MKEadmin/Waterpomp/code_computer/Prullebakken_org.png

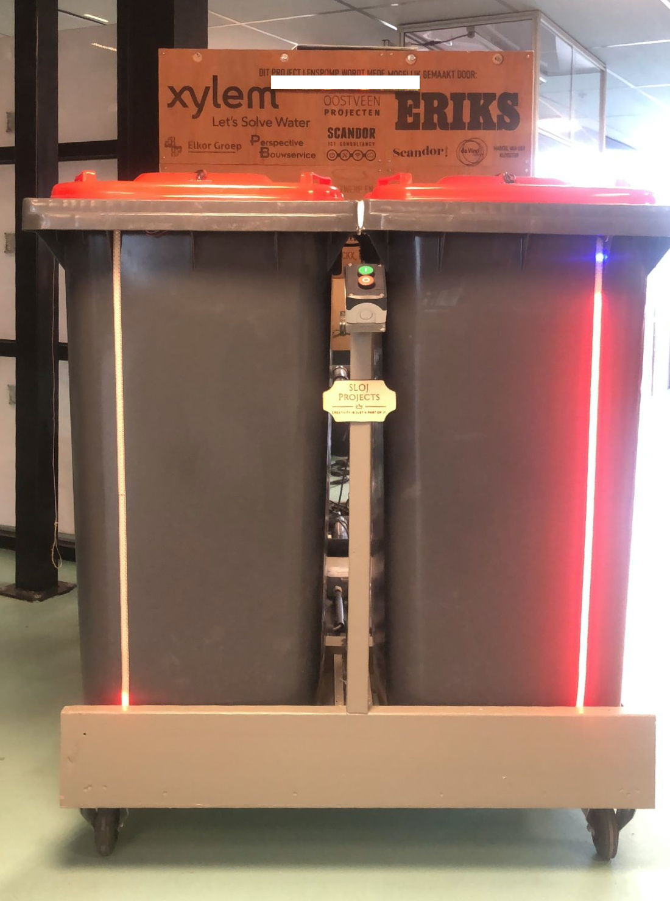
code_computer/Prullebakken_org.png
