MKEadmin/Waterpomp/Documentatie/SLOJ - Motoren en prullebakken/SLOJZERO_Test_1.pdf

# SLOJ PROJECTS

### TESTDOCUMENT I: FUNCTIONALITEIT EN BASIS TESTEN

SLOJ ZERO TEST OPSTELLING

### Getest door: Gecontroleerd door: Test datum: Test formulier nummer:

SLOJ PROJECTS | TESTDOCUMENT I
Schouten, Luijckx, Oostveen en de Jong | Functionaliteit en basis (15 punten)

### Fysieke test

Alleen uit te voeren als tanks gevuld zijn met water en systeem geopend is.

Test punt | Beschrijving | Ja | Nee
1.1 | Pompen lekken geen in de gehele installatie. ✓ Kleppen dienen handmatig open gezet te worden

Opmerkingen

Test punt | Beschrijving | Ja | Nee
1.2 | Installatie niet in bedrijf, projecteert een druk van 0 bar op de displays

Opmerkingen

Schouten, Luijckx, Oostveen en de Jong | Functionaliteit en basis (15 punten)

### Elektrotechnische test:

Systeem aangesloten op drie-fase net 400VAC 50Hz

Test punt | Beschrijving | Ja | Nee
2.1 | ‘Spanning in bedrijf’ lamp 10H1 brandt continu zonder flikkeringen. Automaat 10F1 ingeschakeld en hoofdschakelaar 10S1

Opmerkingen

Test punt | Beschrijving | Ja | Nee
2.2 | Beide pompen tegelijk inschakelen op vol vermogen zonder dat: ✓ Automaat 10F1 afschakelt ✓ MCB 40Q1 / 40Q2 afschakelen ✓ Buitenstaande automaten afschakelen

Opmerkingen

Test punt | Beschrijving | Ja | Nee | Waardes
2.3 | Inkomende spanning 400V. Gemeten op 10S1 Tussen L1-L2, L1-L3, L2-L3, L1-N, L2-N, L3-N | | | L1-L2: L1-L3: L2-L3: L1-N: L2-N: L3-N

Opmerkingen

Test punt | Beschrijving | Ja | Nee
2.4 | PLC reageert op alle inputs (check op display)

Opmerkingen

Schouten, Luijckx, Oostveen en de Jong | Functionaliteit en basis (15 punten)

### Meet- en regel test:

Test punt | Beschrijving | Ja | Nee
3.1 | Pomp 1 inschakelen: ✓ Handmatige functie activeren (20S3) ✓ Schakel kleppen om op de schakelkast. Neem waar dat de flow omdraait. (

Opmerkingen

Test punt | Beschrijving | Ja | Nee
3.2 | Pomp 2 inschakelen volgens ‘Remote Control’: ✓ Schakelkast in handmatige functie zetten (20S3) ✓ Op Remote Control 2 keer de aan functie (24S1) opvragen met een tussenpauze van 1 seconde. ✓ Schakel de kleppen door de aan functie drie seconde in gedrukt te houden

Opmerkingen

Test punt | Beschrijving | Ja | Nee
3.3 | Druk loopt bij vol vermogen (pomp 1 en 2 actief) niet hoger op dan 8,1BAR
3.4 Druk loop bij half vermogen (pomp 1 of 2) | niet hoger op dan 6,1 BAR
3.5 | Druk loopt bij half vermogen (pomp 1 of 2) niet bij de niet-draaiende pomp hoger op dan 1,5 BAR
| Opmerkingen

Schouten, Luijckx, Oostveen en de Jong | Functionaliteit en basis (15 punten)

### Functie testen:

Test punt | Beschrijving | Ja | Nee
4.1 | Functie automatisch programma: Voorwaarden: ✓ Tank 1 is gevuld . ✓ Tank 2 is volledig leeg (Vlotter LAAG geeft een laag signaal af). Functie test: ✓ Bij inschakelen slaan beide pompen aan . ✓ Bij ‘Vlotter MIDDEN’ slaat er één pomp af. ✓ Blij ‘Vlotter HOOG’ slaan alle pompen af.

Opmerkingen

Test punt | Beschrijving | Ja | Nee
4.2 | Functie demo programma: Voorwaarden: ✓ Automatisch programma is ingeschakeld Functie test: ✓ Druk de uitknop (20S2/ 24S2) 10 seconden in ✓ Tank 2 wordt gevuld tot Vlotter HOOG ✓ Omkeer schakeling schakelt kleppen om ✓ Tank 1 wordt gevuld totdat Vlotter LAAG in Tank 2 laag is

Opmerkingen

Schouten, Luijckx, Oostveen en de Jong | Functionaliteit en basis (15 punten)
Test punt | Beschrijving | Ja | Nee
4.3 | Functie: Remote control I Voorwaarden: ✓ Handmatig programma geactiveerd Functie test: ✓ Druk de aan knop (24S1) eenmaal in. Pomp 1 gaat nu aan ✓ Druk de aan knop (24S1) nogmaals in. Pomp 2 gaat nu aan en pomp 1 valt af ✓ Druk de aan knop (24S1) nogmaals in. Beide pompen draaien nu

Opmerkingen

Test punt | Beschrijving | Ja | Nee
4.4 | Functie: Remote control II Voorwaarden: ✓ Handmatig programma geactiveerd ✓ Pompen draaien niet Functie test: ✓ Druk de aan knop (24S1) in voor drie seconden, neem waar dat de kleppen omschakelen ✓ Druk de aan knop (24S1) eenmaal in zodat pomp 1 gaat draaien ✓ Druk de aan knop (24S1) in voor drie seconde, neem waar dat de kleppen nogmaals omschakelen

Opmerkingen

Schouten, Luijckx, Oostveen en de Jong | Functionaliteit en basis (15 punten)

### Tijden controle:

Test punt | Beschrijving | Ja | Nee | Waardes
5.1 | Pomp 1 doet er maximaal xxx aantal seconden over om tank 1 over te pompen naar tank 2. | | | Tijd in seconden:
Test punt | Beschrijving | Ja | Nee | Waardes
5.2 | Pomp 1+2 doen er maximaal xxx aantal seconden over om tank 1 over te pompen naar tank 2. | | | Tijd in seconden:
