MKEadmin/Waterpomp/Documentatie/SLOJ - Motoren en prullebakken/DV_SLS005 SMARTLENS POMP revE AS BUILT.pdf

3011TT

## Leerpark

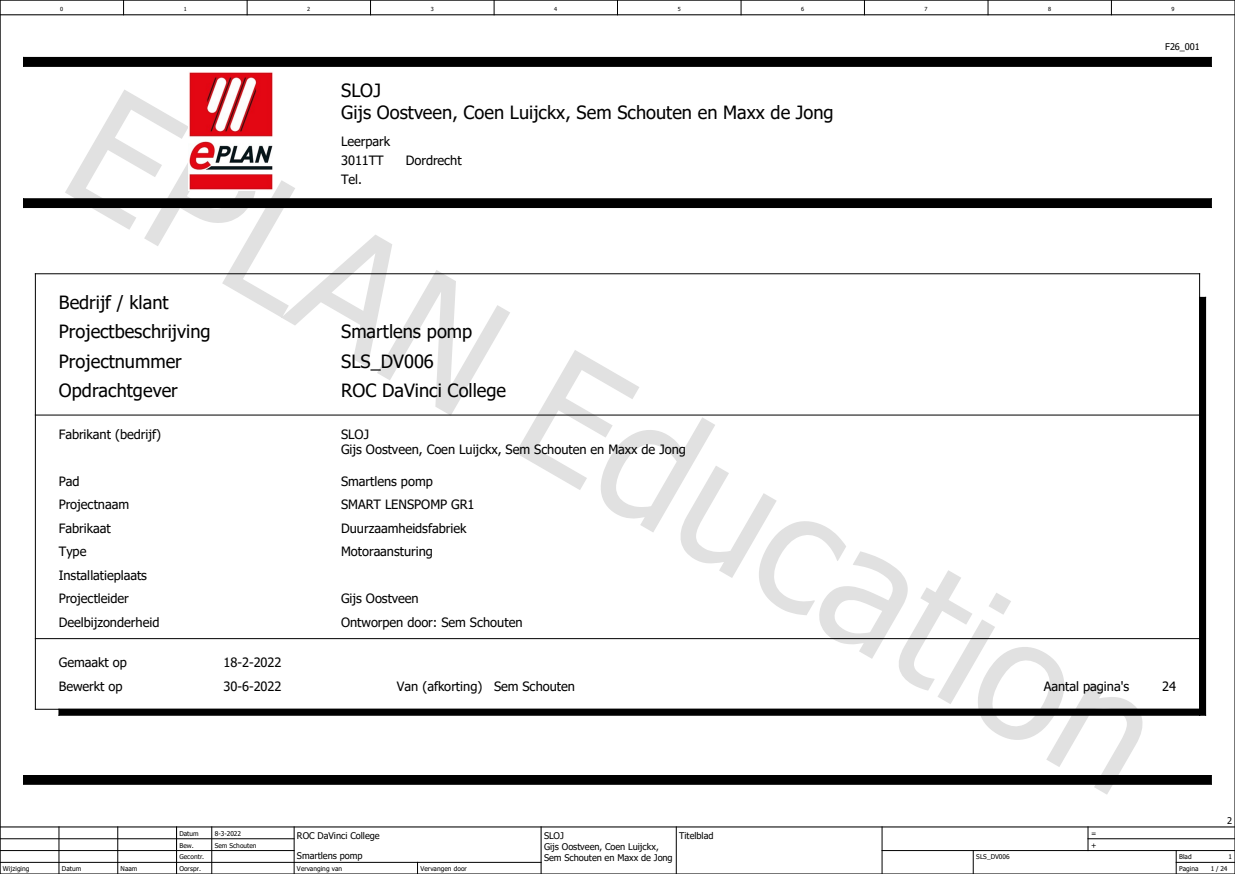
[picture p2: page 1]
Projectbeschrijving; Smartlens pomp; Aantal pagina's; Opdrachtgever; Bewerkt op; Gemaakt op; Duurzaamheidsfabriek; Projectnummer; Fabrikaat; Sem Schouten; Deelbijzonderheid; Pad; Motoraansturing; Fabrikant (bedrijf); Projectnaam; SMART LENSPOMP GR1; Projectleider; Tel.; Type; Bedrijf / klant; Installatieplaats; Van (afkorting); Dordrecht

SLOJ
Gijs Oostveen, Coen Luijckx, Sem Schouten en Maxx de Jong

SLS_DV006
ROC DaVinci College

Gijs Oostveen
Ontworpen door: Sem Schouten

8-3-2022 | ROC DaVinci College Smartlens pomp | SLOJ Gijs Oostveen, Coen Luijckx, Sem Schouten en Maxx de Jong | Titelblad | =

Bew. | Sem Schouten | | | | +
Gecontr. | | | | | SLS_DV006 | 1 Blad

Wijziging | Datum | Naam | Oorspr. | | Vervanging van | Vervangen door | | | | Pagina 1 / 24

# Inhoudsopgave

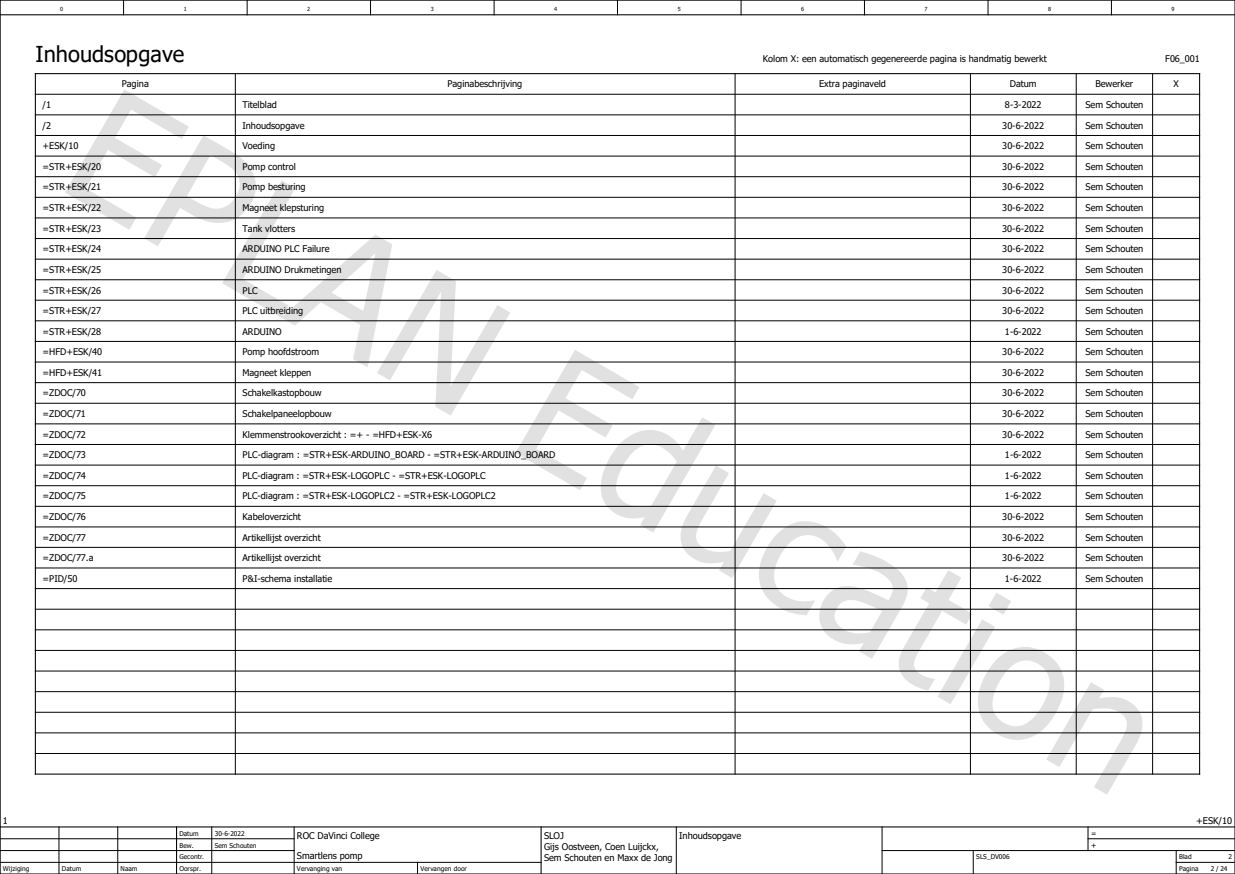
[picture p3: page 2]
Inhoudsopgave; +ESK/10; SLOJ; Sem Schouten en Maxx de Jong

Kolom X: een automatisch gegenereerde pagina is handmatig bewerkt

Pagina | Paginabeschrijving | Extra paginaveld | Datum | Bewerker | X

/1 | | | 8-3-2022 | Sem Schouten Titelblad
/2 | | | 30-6-2022 | Sem Schouten Inhoudsopgave
+ESK/10 | | | 30-6-2022 | Sem Schouten Voeding
=STR+ESK/20 | | | 30-6-2022 | Sem Schouten Pomp control
=STR+ESK/21 | | | 30-6-2022 | Sem Schouten Pomp besturing
=STR+ESK/22 | | | 30-6-2022 | Sem Schouten Magneet klepsturing
=STR+ESK/23 | | | 30-6-2022 | Sem Schouten Tank vlotters
=STR+ESK/24 | | | 30-6-2022 | Sem Schouten ARDUINO PLC Failure
=STR+ESK/25 | | | 30-6-2022 | Sem Schouten ARDUINO Drukmetingen
=STR+ESK/26 | | | 30-6-2022 | Sem Schouten PLC
=STR+ESK/27 | | | 30-6-2022 | Sem Schouten PLC uitbreiding
=STR+ESK/28 | | | 1-6-2022 | Sem Schouten ARDUINO
=HFD+ESK/40 | | | 30-6-2022 | Sem Schouten Pomp hoofdstroom
=HFD+ESK/41 | | | 30-6-2022 | Sem Schouten Magneet kleppen
=ZDOC/70 | | | 30-6-2022 | Sem Schouten Schakelkastopbouw
=ZDOC/71 | | | 30-6-2022 | Sem Schouten Schakelpaneelopbouw
=ZDOC/72 | | | 30-6-2022 | Sem Schouten Klemmenstrookoverzicht : =+ - =HFD+ESK-X6
=ZDOC/73 | | | 1-6-2022 | Sem Schouten PLC-diagram : =STR+ESK-ARDUINO_BOARD - =STR+ESK-ARDUINO_BOARD
=ZDOC/74 | | | 1-6-2022 | Sem Schouten PLC-diagram : =STR+ESK-LOGOPLC - =STR+ESK-LOGOPLC
=ZDOC/75 | | | 1-6-2022 | Sem Schouten PLC-diagram : =STR+ESK-LOGOPLC2 - =STR+ESK-LOGOPLC2
=ZDOC/76 | | | 30-6-2022 | Sem Schouten Kabeloverzicht
=ZDOC/77 | | | 30-6-2022 | Sem Schouten Artikellijst overzicht
=ZDOC/77.a | | | 30-6-2022 | Sem Schouten Artikellijst overzicht
=PID/50 | | | 1-6-2022 | Sem Schouten P&I-schema installatie

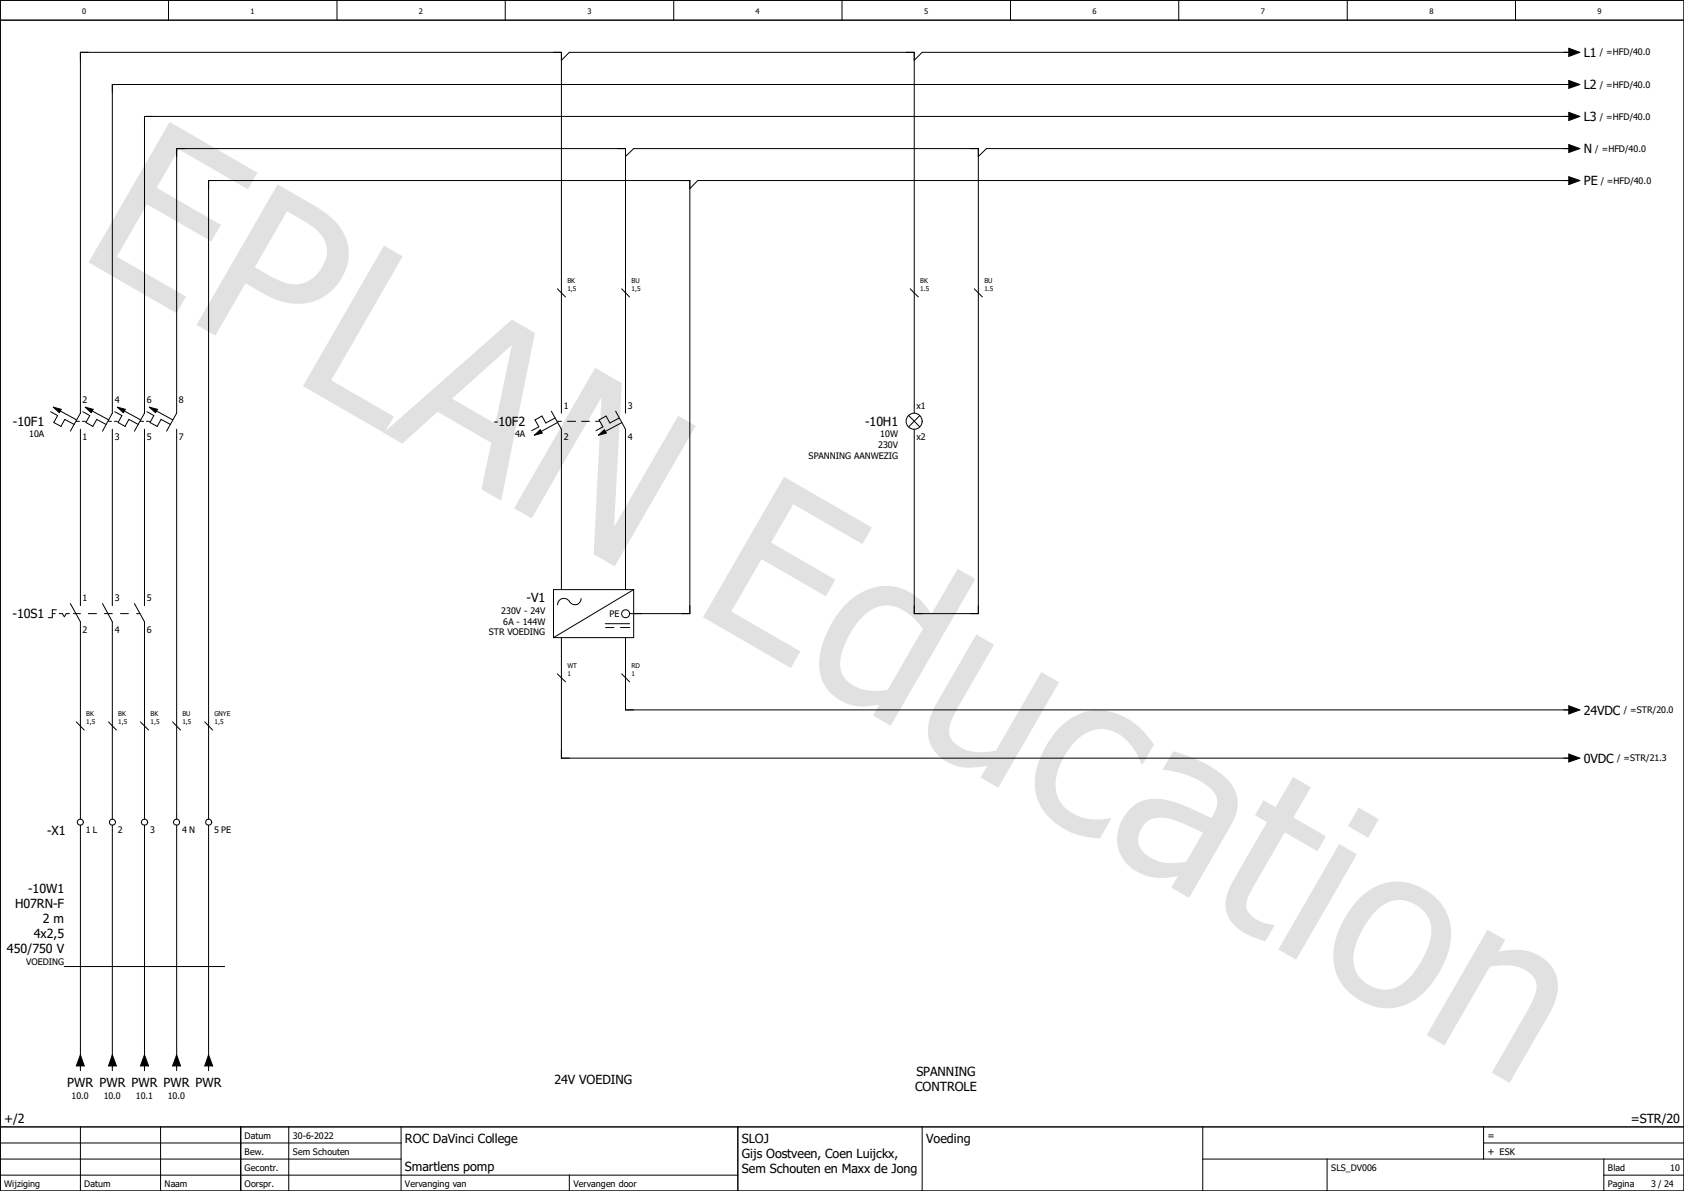
[picture p4: page 3]
ESK; Voeding; =STR/20; Sem Schouten en Maxx de Jong; SPANNING CONTROLE 24V VOEDING; -V1 230V - 24V 6A - 144W STR VOEDING; VOEDING; GNYE; -10H1 10W 230V SPANNING AANWEZIG; N / =HFD/40.0; PE / =HFD/40.0; 24VDC / =STR/20.0; L2 / =HFD/40.0; L3 / =HFD/40.0; PWR 10.0; PWR 10.1; PWR; 0VDC / =STR/21.3; L1 / =HFD/40.0

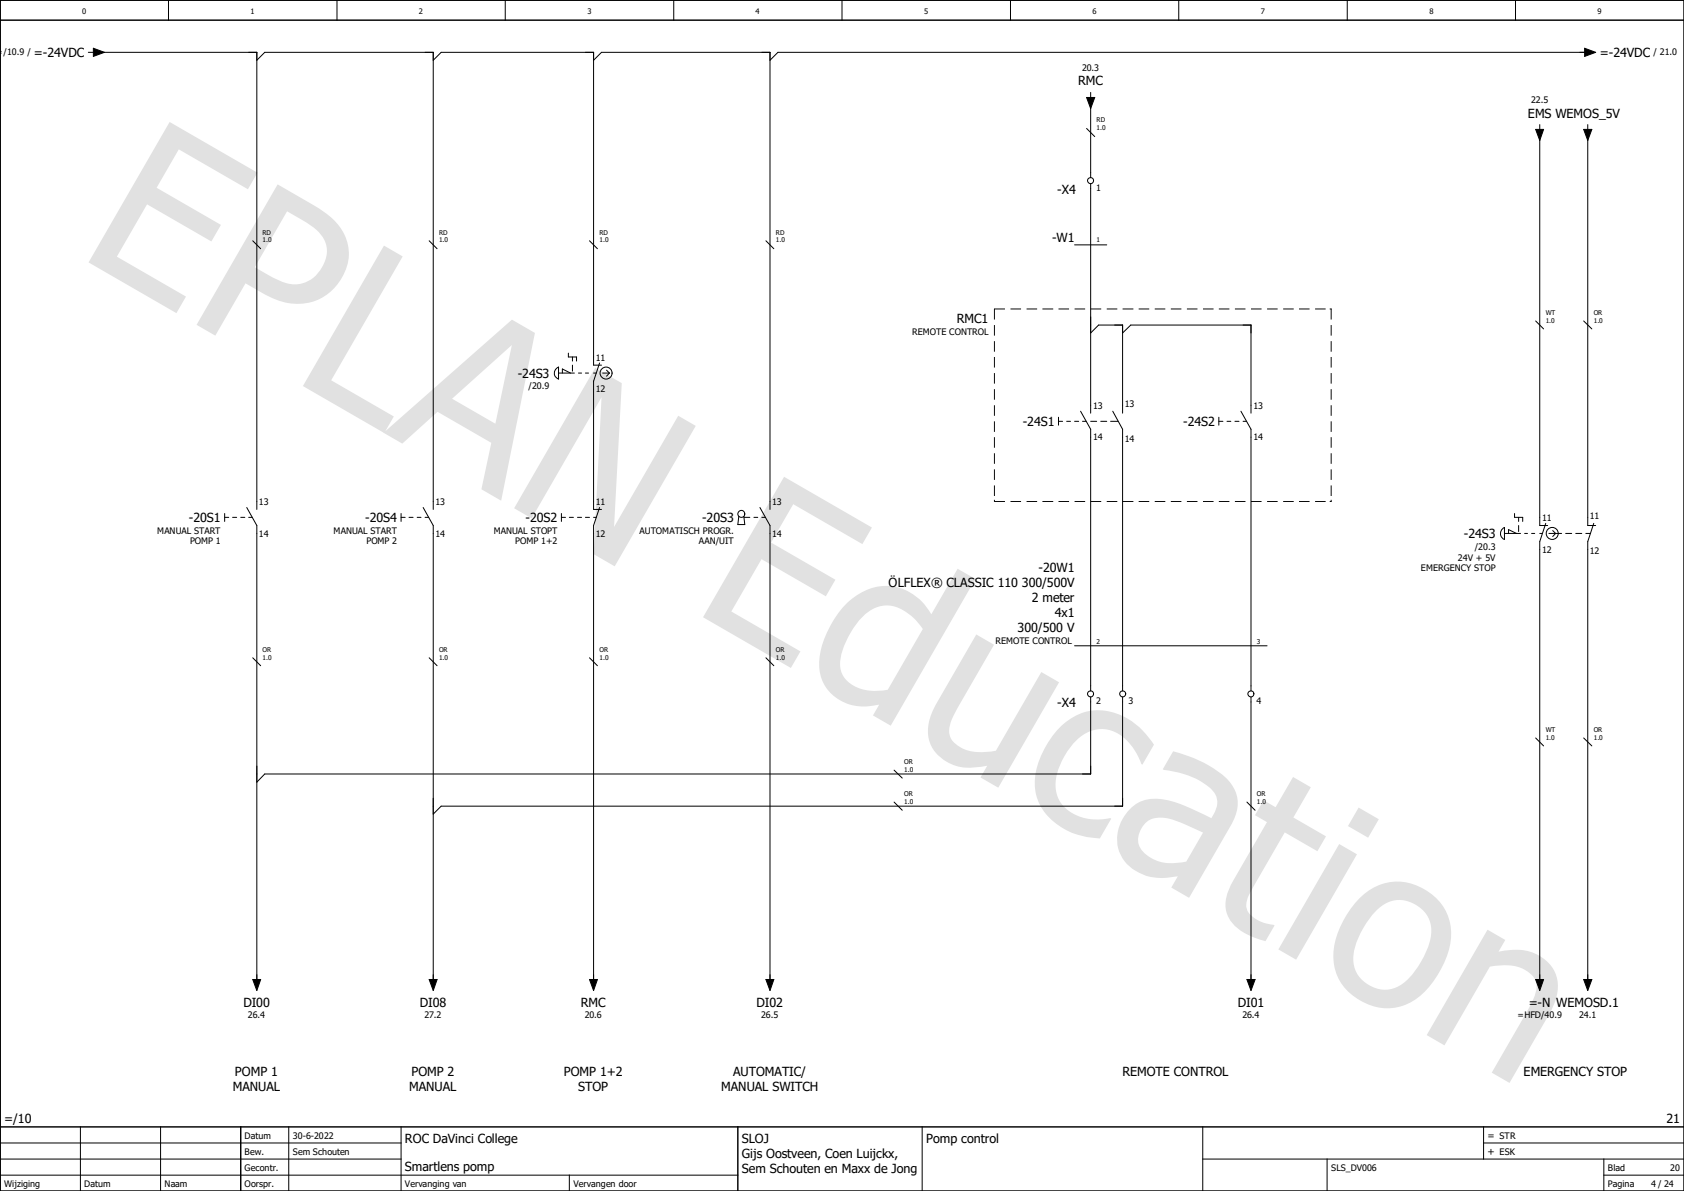
[picture p5: page 4]
STR; Pomp control; Sem Schouten en Maxx de Jong; POMP 1; REMOTE CONTROL; MANUAL; POMP 2 MANUAL; AUTOMATIC/ MANUAL SWITCH; POMP 1+2 STOP; EMERGENCY STOP; -20S1 MANUAL START POMP 1; -20S2 MANUAL STOPT POMP 1+2; -20S3 AUTOMATISCH PROGR. AAN/UIT; RMC1 REMOTE CONTROL; 2 meter; ÖLFLEX® CLASSIC 110 300/500V; -24S3 /20.3 24V + 5V EMERGENCY STOP; -20S4 MANUAL START POMP 2; =/10.9 / =-24VDC; =-24VDC / 21.0; WEMOS_5V; WEMOSD.1 24.1; =-N =HFD/40.9; EMS; RMC; RMC 20.6

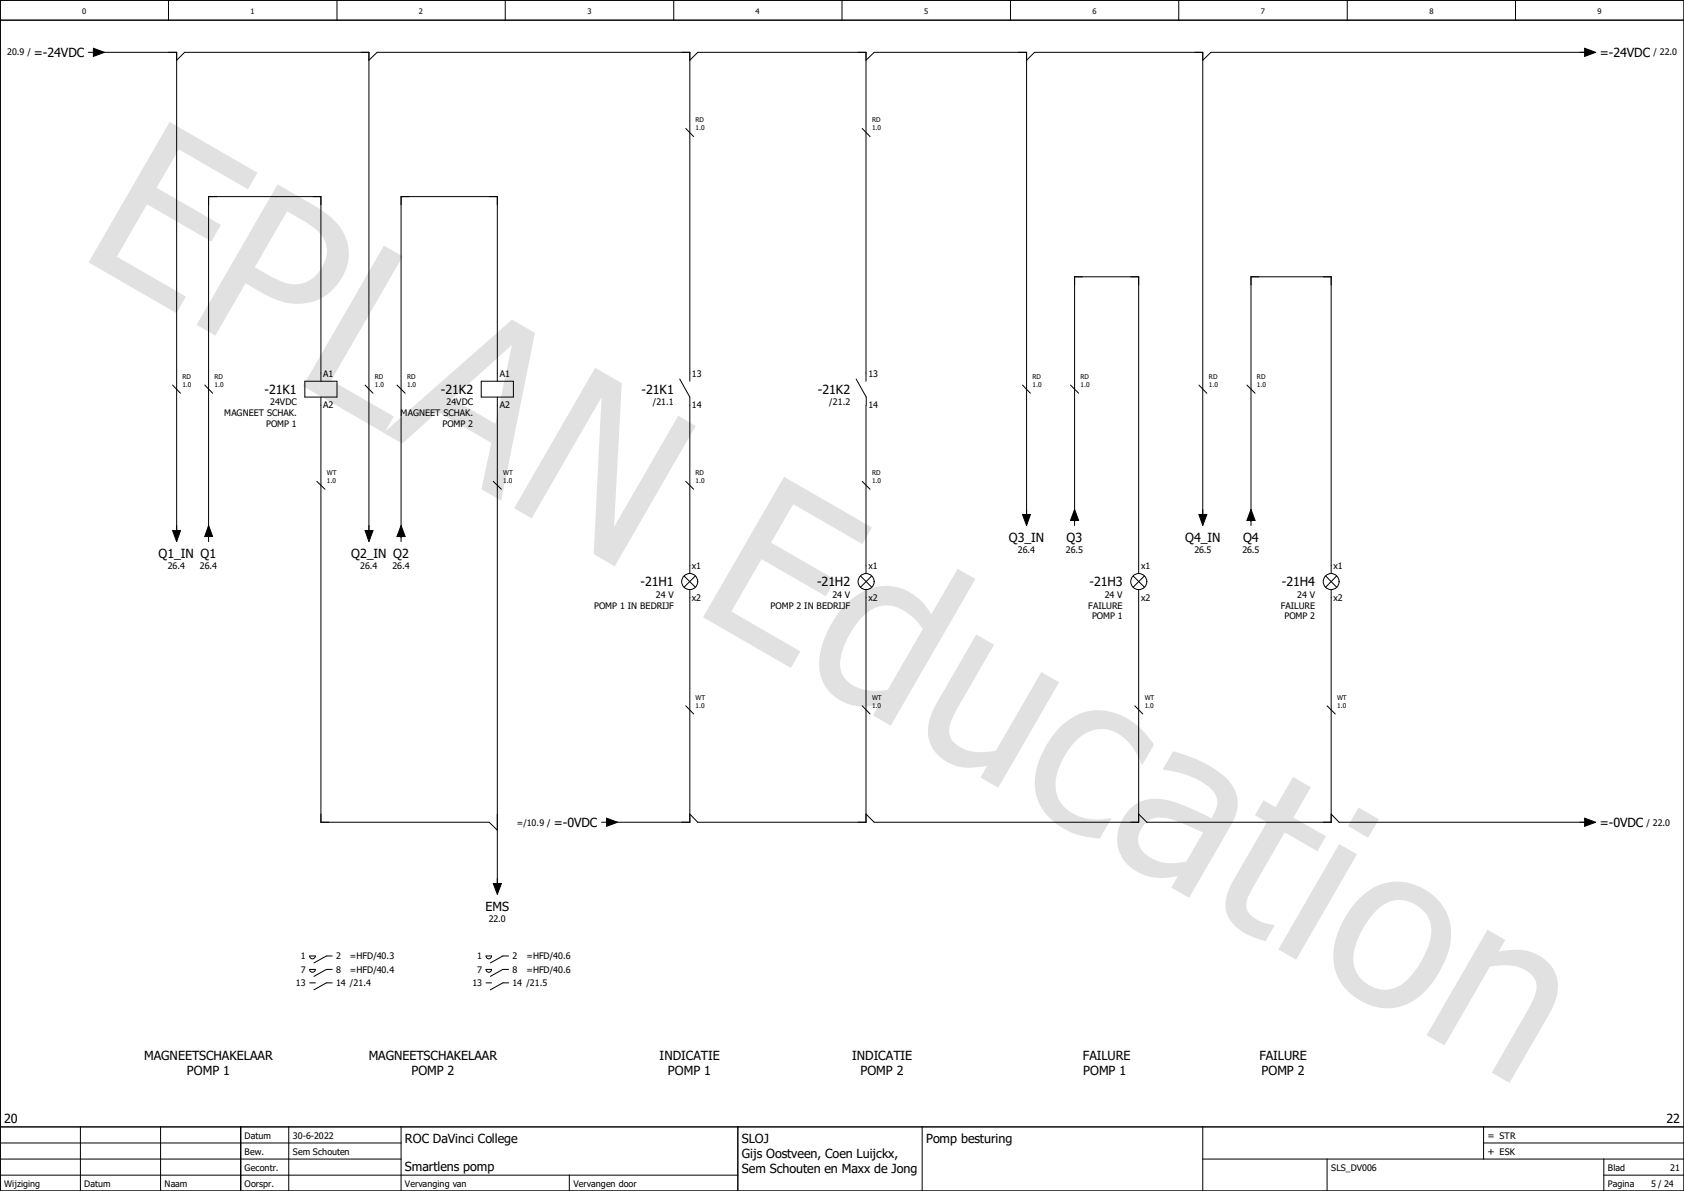
[picture p6: page 5]
STR; Pomp besturing; Sem Schouten en Maxx de Jong; MAGNEETSCHAKELAAR POMP 1; MAGNEETSCHAKELAAR POMP 2; INDICATIE POMP 1; INDICATIE POMP 2; FAILURE POMP 1; FAILURE POMP 2; -21K1 24VDC MAGNEET SCHAK. POMP 1; 1 2 =HFD/40.3 7 8 =HFD/40.4 13 14 /21.4; -21K2 24VDC MAGNEET SCHAK. POMP 2; 1 2 =HFD/40.6 7 8 =HFD/40.6 13 14 /21.5; -21H3 24 V FAILURE POMP 1; -21H4 24 V FAILURE POMP 2; 20.9 / =-24VDC; =-24VDC / 22.0; =/10.9 / =-0VDC; EMS 22.0; =-0VDC / 22.0

POMP 1 IN BEDRIJF

POMP 2 IN BEDRIJF

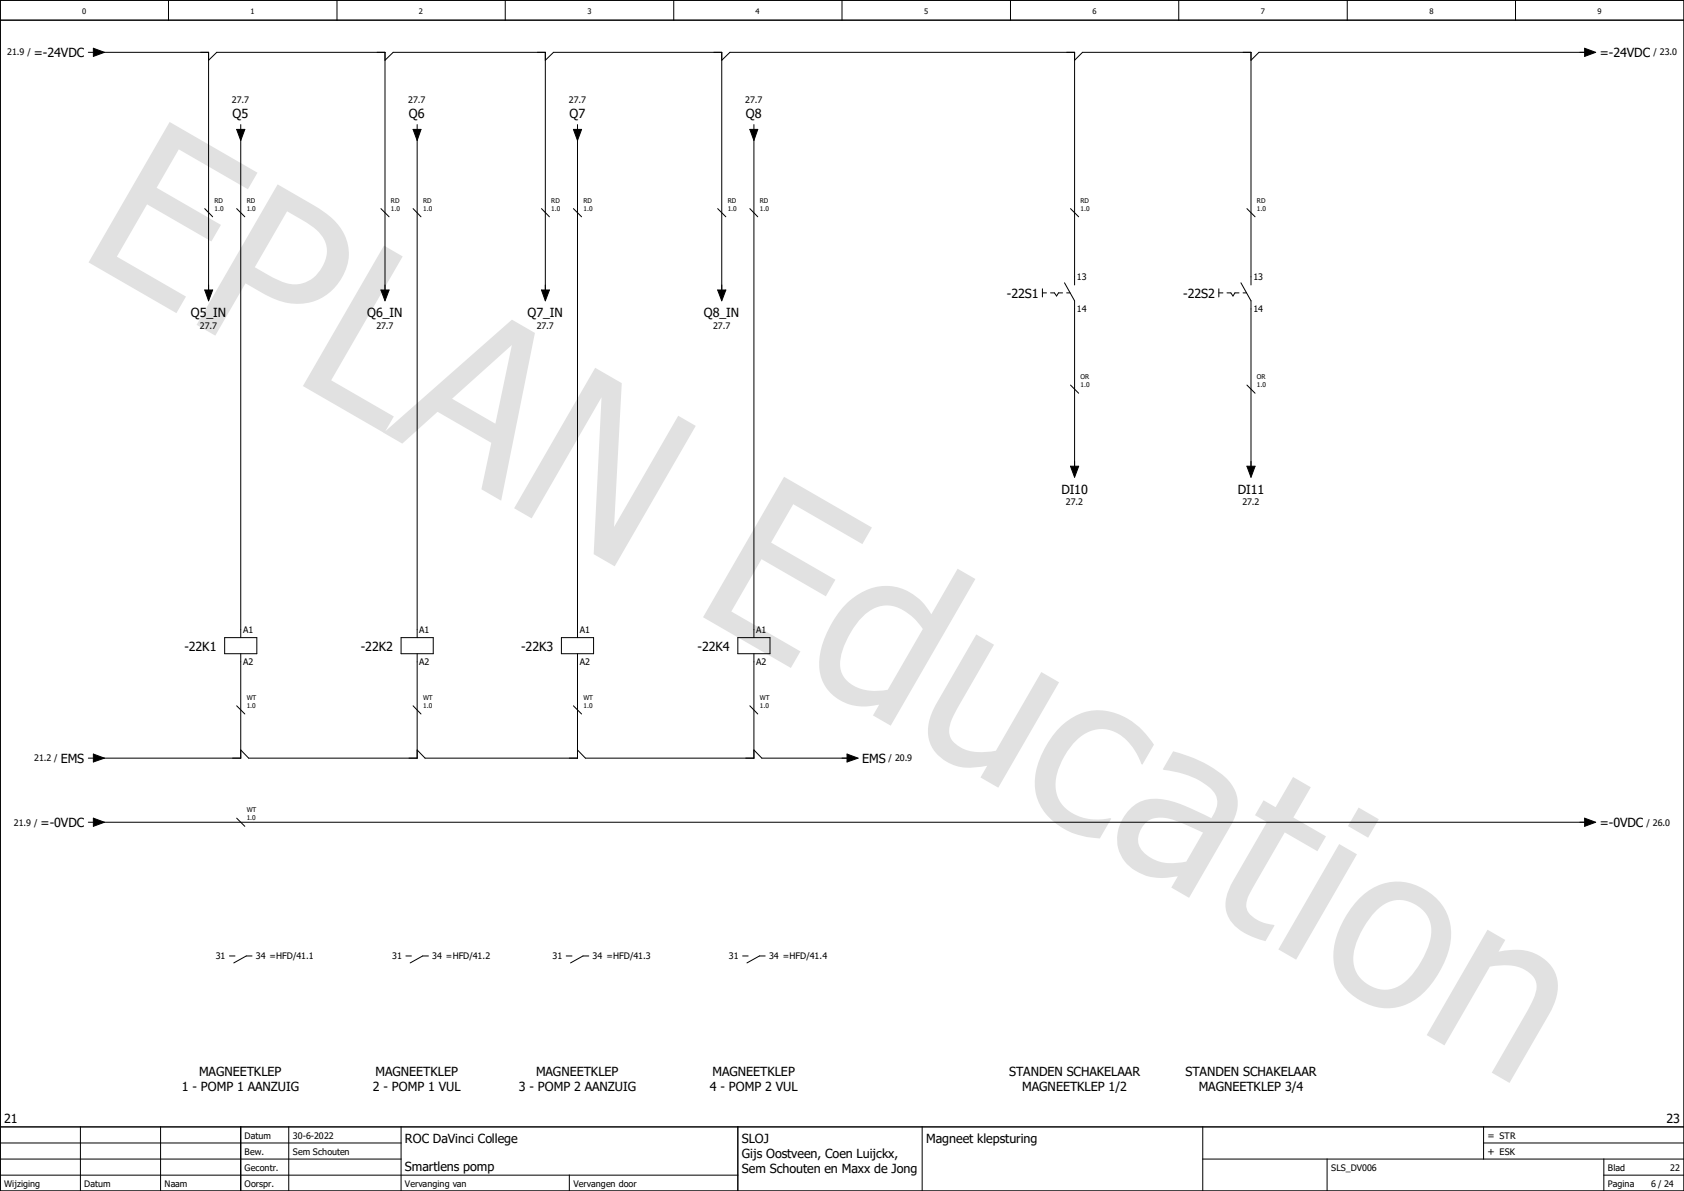
[picture p7: page 6]
STR; Magneet klepsturing; Sem Schouten en Maxx de Jong; MAGNEETKLEP 1 - POMP 1 AANZUIG; MAGNEETKLEP 2 - POMP 1 VUL; MAGNEETKLEP 3 - POMP 2 AANZUIG; MAGNEETKLEP 4 - POMP 2 VUL; STANDEN SCHAKELAAR MAGNEETKLEP 1/2; STANDEN SCHAKELAAR MAGNEETKLEP 3/4; 31 34 =HFD/41.1; 31 34 =HFD/41.2; 31 34 =HFD/41.3; 31 34 =HFD/41.4; 21.9 / =-24VDC; =-24VDC / 23.0; 21.2 / EMS; EMS / 20.9; 21.9 / =-0VDC; =-0VDC / 26.0

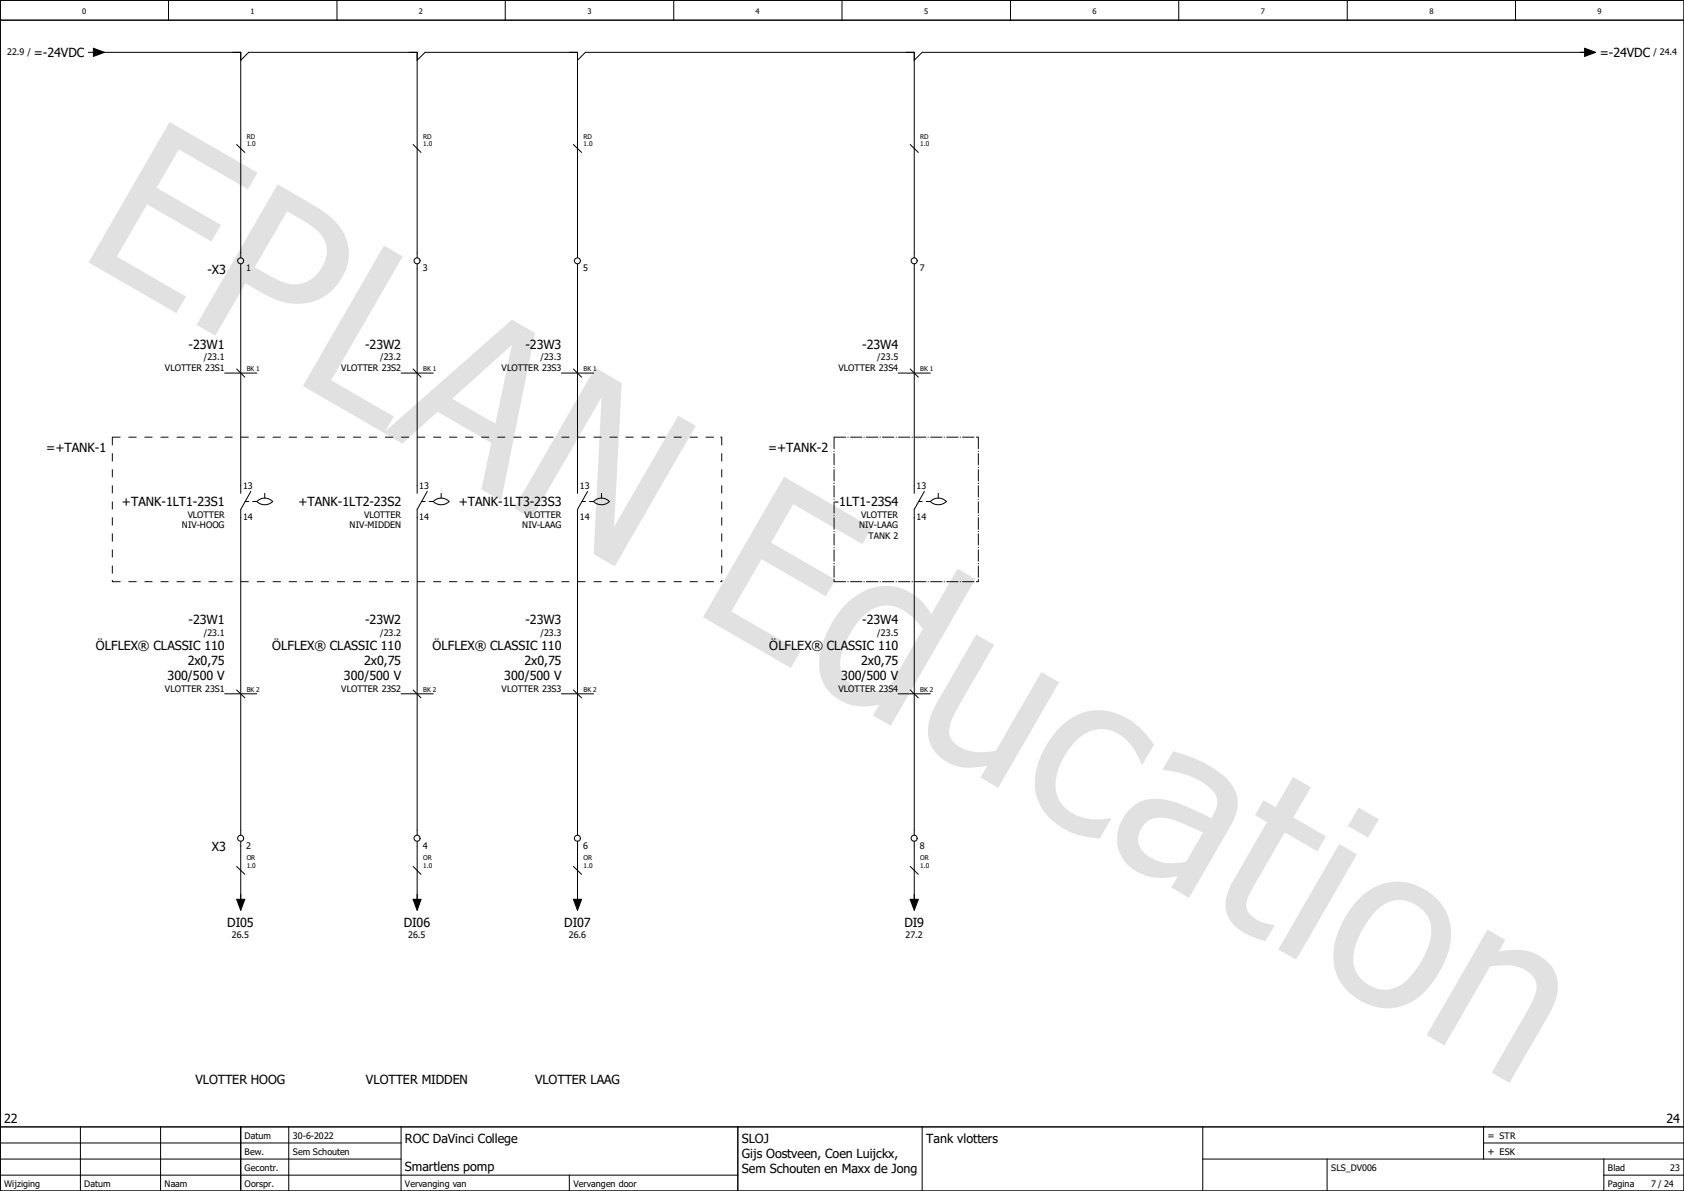
[picture p8: page 7]
STR; Tank vlotters; Sem Schouten en Maxx de Jong; VLOTTER HOOG; VLOTTER MIDDEN; VLOTTER LAAG; =+TANK-1; VLOTTER 23S1; ÖLFLEX® CLASSIC 110; VLOTTER 23S2; VLOTTER 23S3; +TANK-1LT1-23S1 VLOTTER NIV-HOOG; +TANK-1LT2-23S2 VLOTTER NIV-MIDDEN; +TANK-1LT3-23S3 VLOTTER NIV-LAAG; VLOTTER 23S4; -1LT1-23S4 VLOTTER NIV-LAAG TANK 2; =+TANK-2; 22.9 / =-24VDC; =-24VDC / 24.4

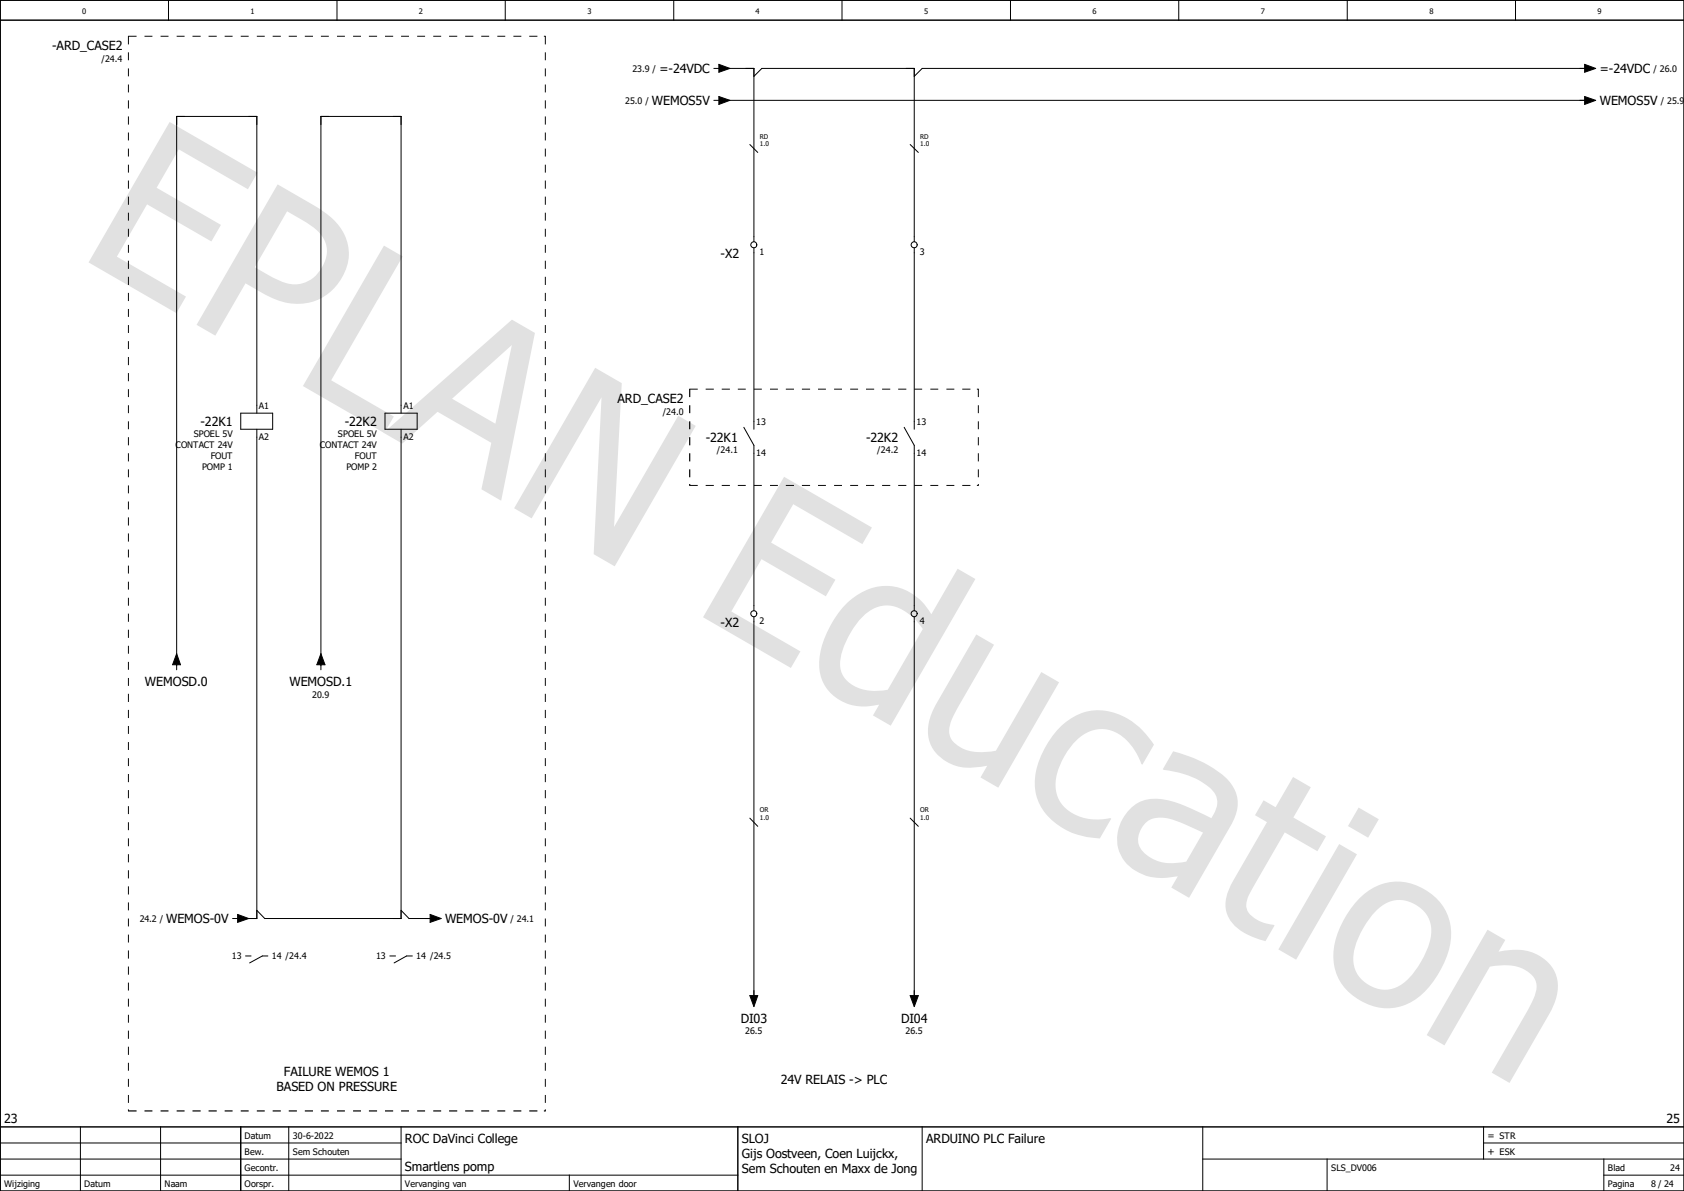
[picture p9: page 8]
STR; Sem Schouten en Maxx de Jong; FAILURE WEMOS 1; BASED ON PRESSURE; 24V RELAIS -> PLC; -22K1 SPOEL 5V CONTACT 24V FOUT POMP 1; -22K2 SPOEL 5V CONTACT 24V FOUT POMP 2; ARD_CASE2 /24.0; -ARD_CASE2 /24.4; 24.2 / WEMOS-0V; WEMOS-0V / 24.1; 23.9 / =-24VDC; =-24VDC / 26.0; WEMOSD.0; WEMOSD.1; 25.0 / WEMOS5V; WEMOS5V / 25.9

ARDUINO PLC Failure

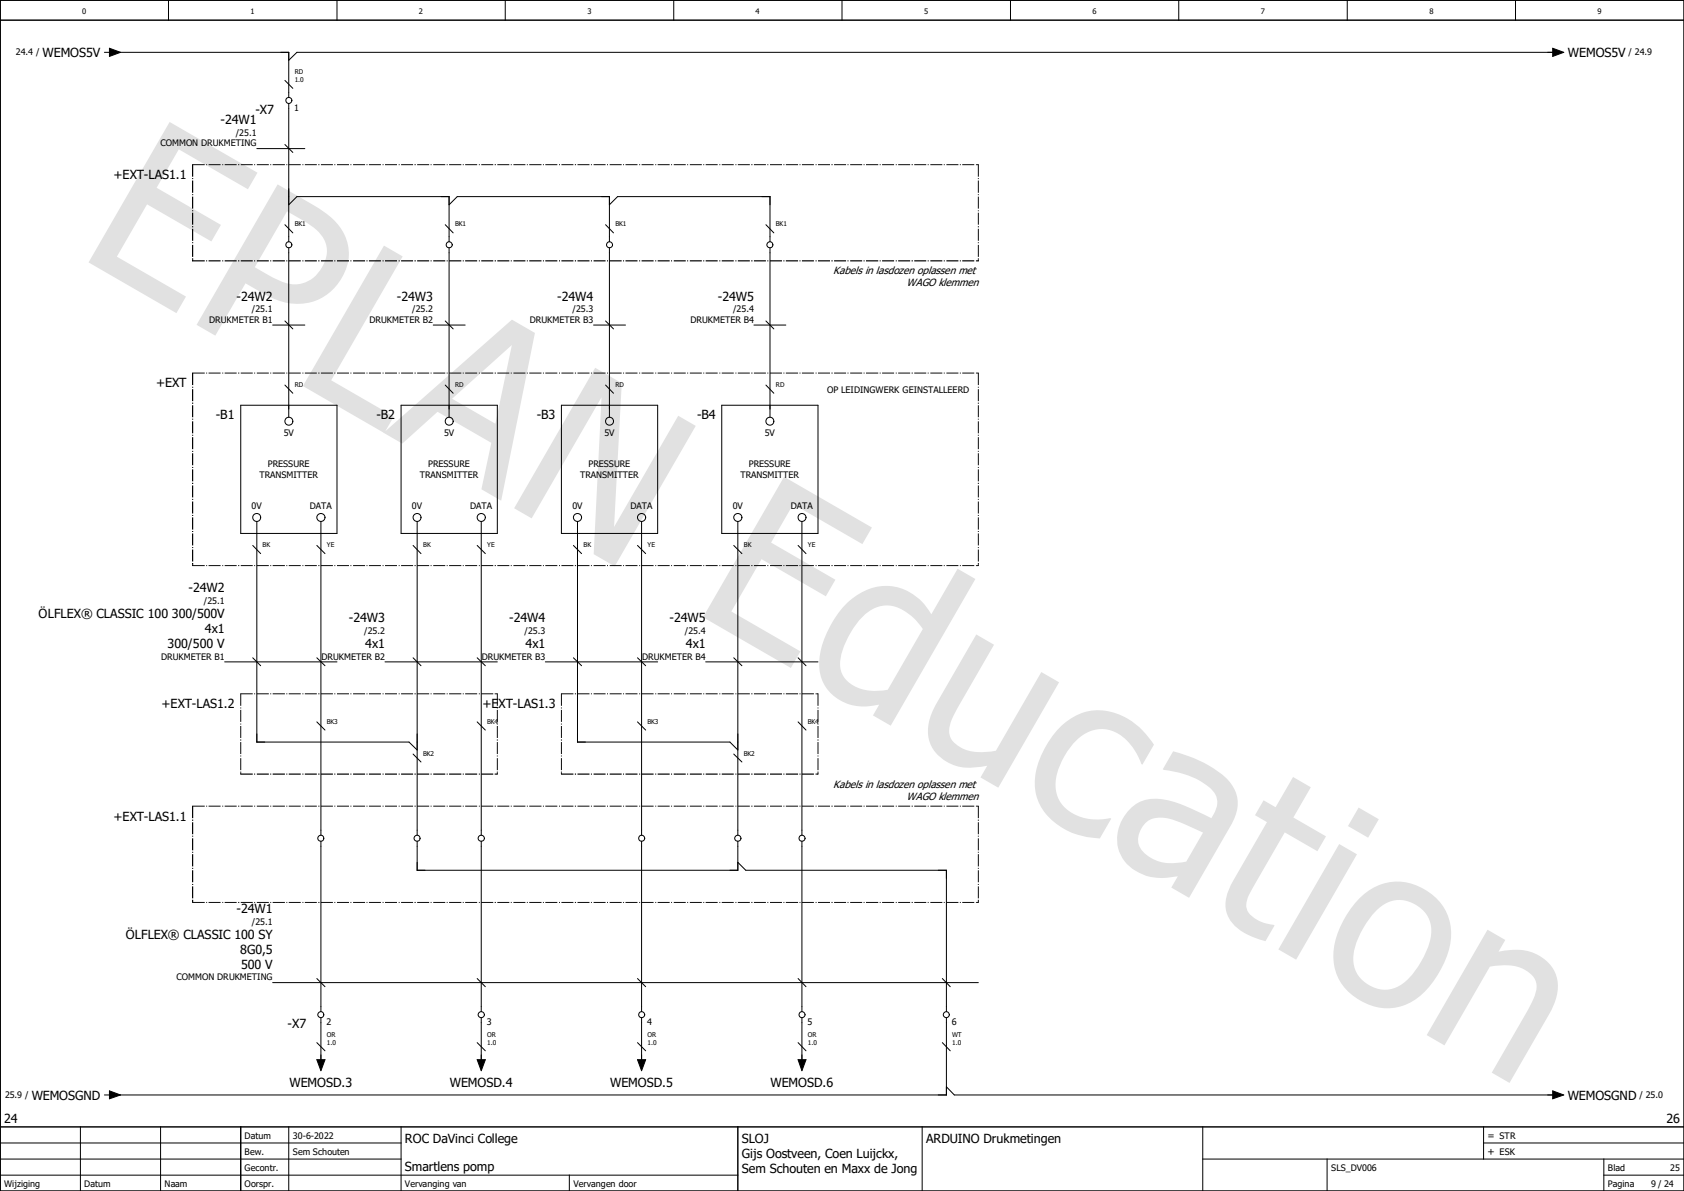
[picture p10: page 9]
STR; ARDUINO Drukmetingen; Sem Schouten en Maxx de Jong; PRESSURE TRANSMITTER; WAGO klemmen; +EXT-LAS1.1; DATA; COMMON DRUKMETING; DRUKMETER B1; ÖLFLEX® CLASSIC 100 300/500V; DRUKMETER B2; DRUKMETER B3; DRUKMETER B4; +EXT; +EXT-LAS1.2; +EXT-LAS1.3; 24.4 / WEMOS5V; WEMOS5V / 24.9; WEMOSD.3; WEMOSD.4; WEMOSD.5; WEMOSD.6; 25.9 / WEMOSGND; WEMOSGND / 25.0

Kabels in lasdozen oplassen met

OP LEIDINGWERK GEINSTALLEERD

ÖLFLEX® CLASSIC 100 SY

## I1 I0.0 MANUAL START

## I2 I0.1 MANUAL STOP

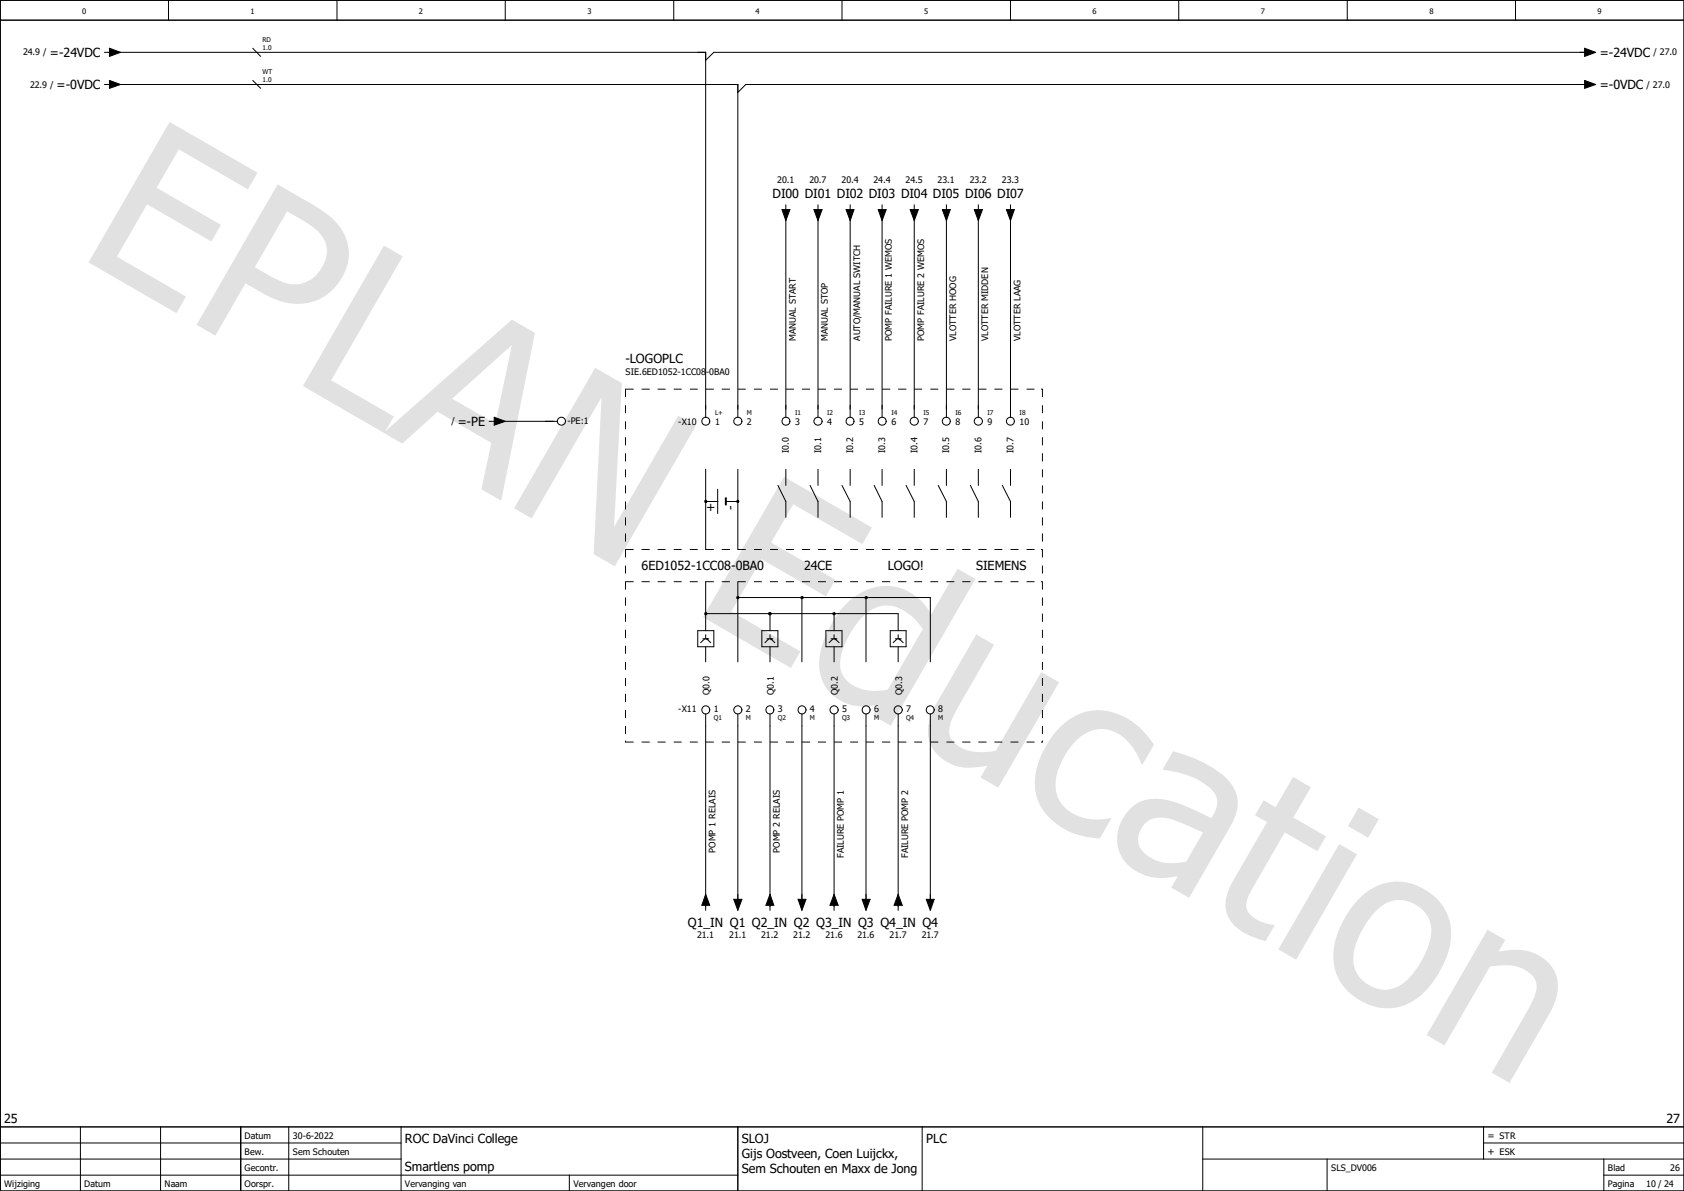
[picture p11: page 10]
STR; PLC; Sem Schouten en Maxx de Jong; I7 I0.6 VLOTTER MIDDEN; SIE.6ED1052-1CC08-0BA0; -LOGOPLC; LOGO!; SIEMENS; I8 I0.7 VLOTTER LAAG; 24.9 / =-24VDC; =-24VDC / 27.0; 22.9 / =-0VDC; =-0VDC / 27.0

I4 I0.3 POMP FAILURE 1 WEMOS
I3 I0.2 AUTO/MANUAL SWITCH

I5 I0.4 POMP FAILURE 2 WEMOS
I6 I0.5 VLOTTER HOOG

Q1 Q⁰.0 POMP 1 RELAIS

Q2 Q⁰.1 POMP 2 RELAIS

Q3 Q⁰.2 FAILURE POMP 1

Q4 Q⁰.3 FAILURE POMP 2

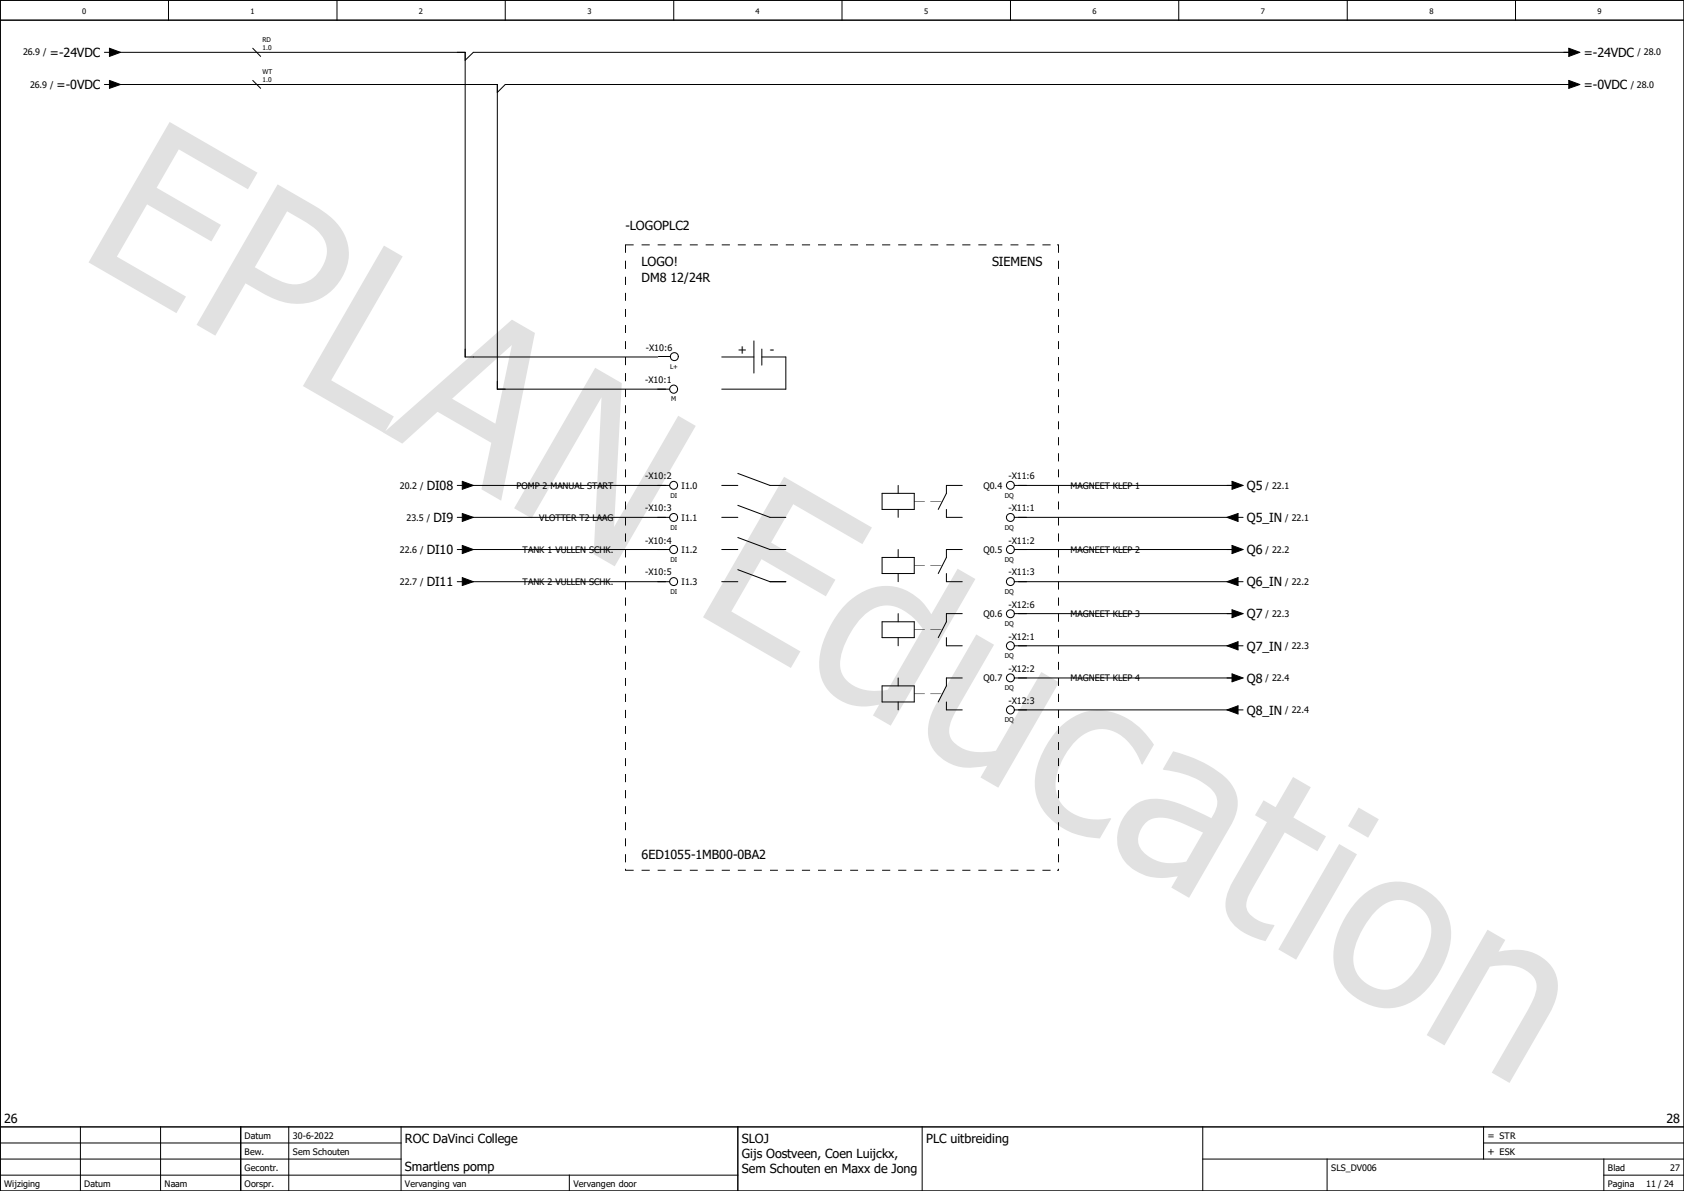
[picture p12: page 11]
STR; PLC uitbreiding; Sem Schouten en Maxx de Jong; -LOGOPLC2; SIEMENS; LOGO!; MAGNEET KLEP 1; MAGNEET KLEP 2; MAGNEET KLEP 3; MAGNEET KLEP 4; VLOTTER T2 LAAG; 26.9 / =-24VDC; =-24VDC / 28.0; 26.9 / =-0VDC; =-0VDC / 28.0

POMP 2 MANUAL START

TANK 1 VULLEN SCHK.

TANK 2 VULLEN SCHK.

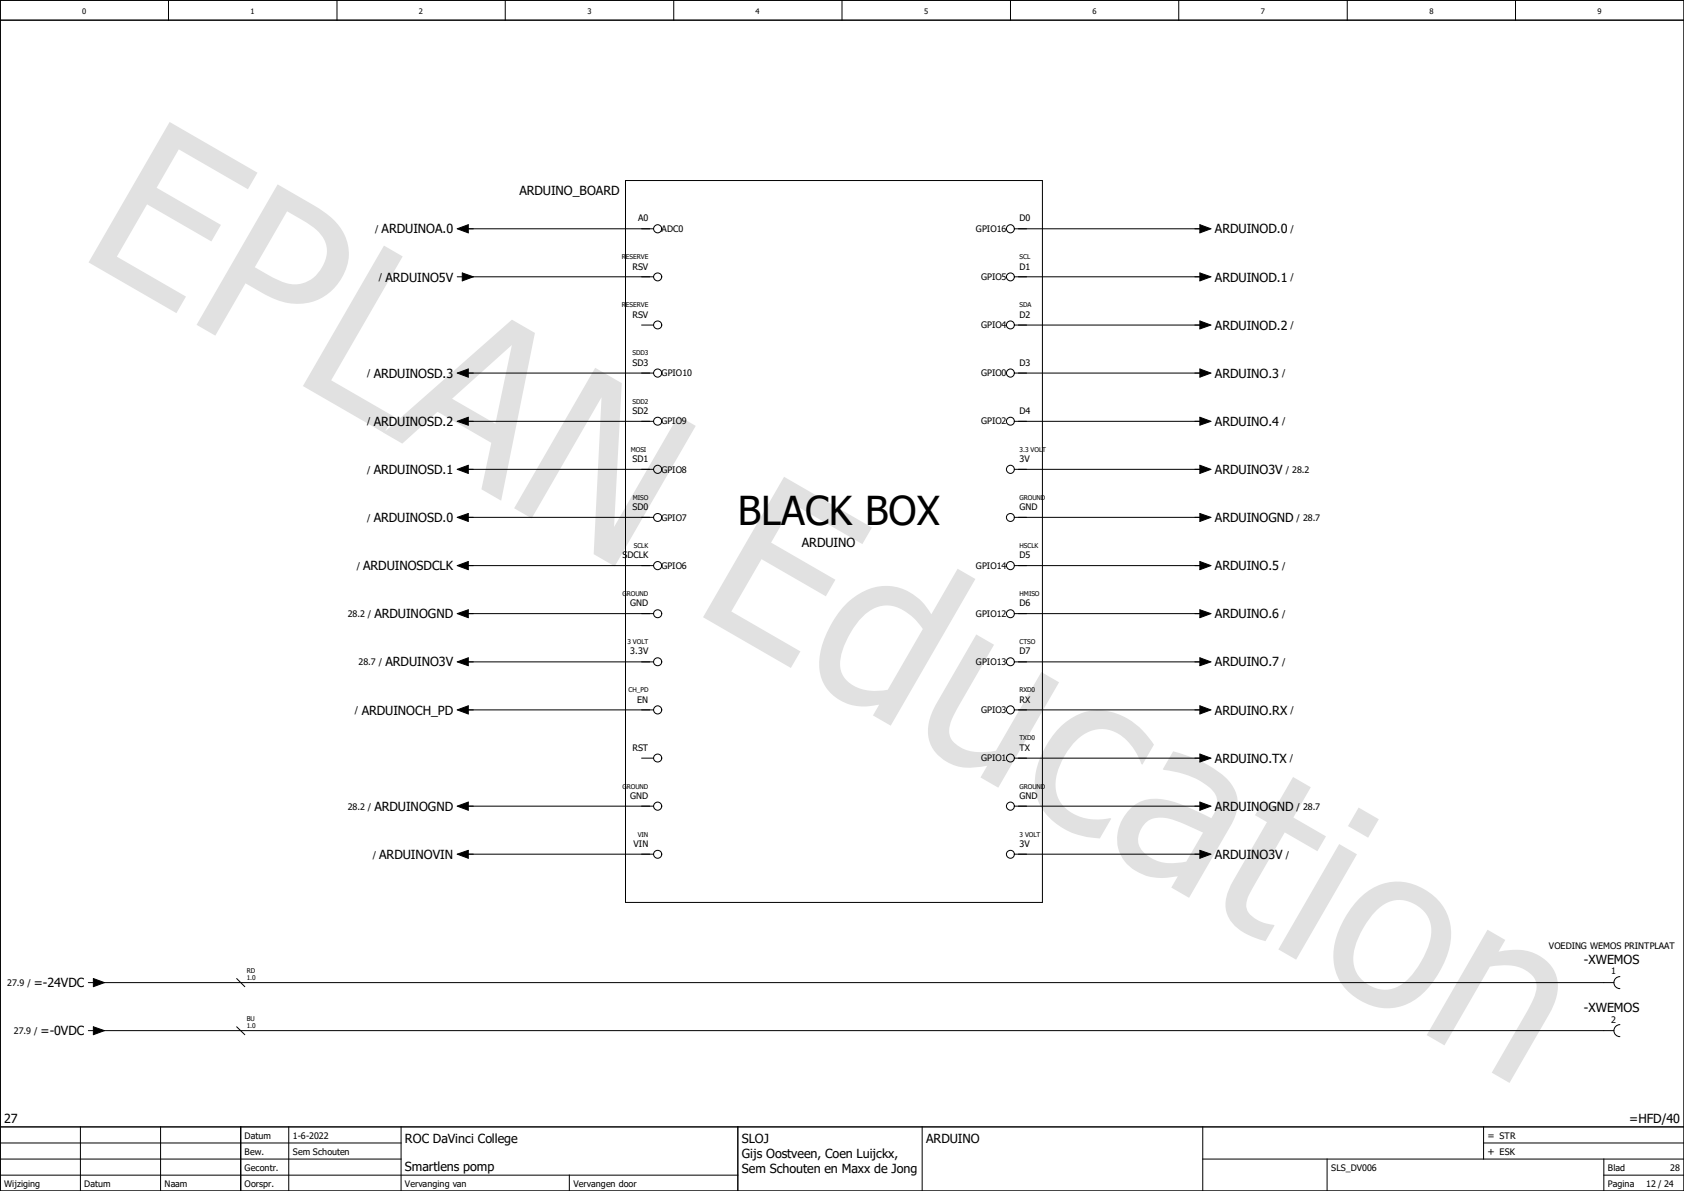
[picture p13: page 12]

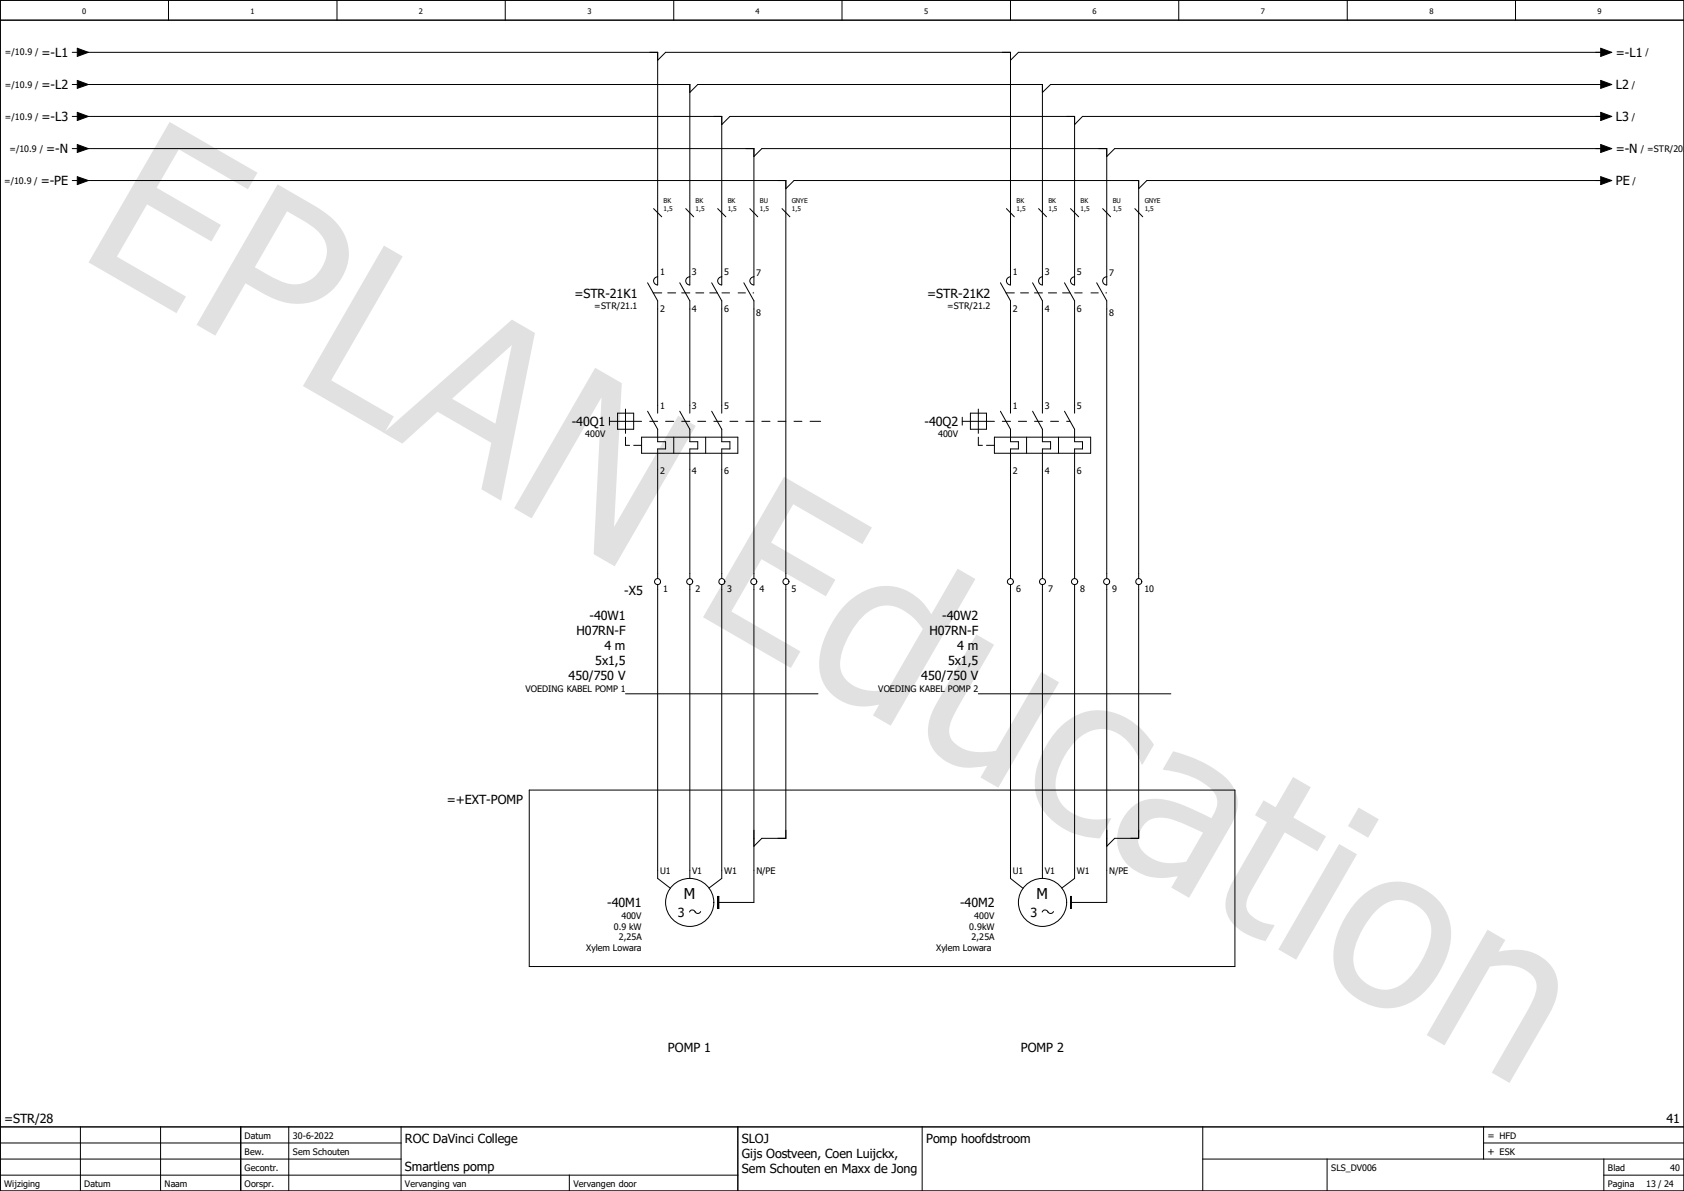
[picture p14: page 13]
=STR/28; HFD; Pomp hoofdstroom; Sem Schouten en Maxx de Jong; POMP 1; POMP 2; =+EXT-POMP; =STR-21K1 =STR/21.1; =STR-21K2 =STR/21.2; GNYE; -40M1 400V 0.9 kW 2,25A Xylem Lowara; -40M2 400V 0.9kW 2,25A Xylem Lowara; =-N / =STR/20.9

VOEDING KABEL POMP 1

VOEDING KABEL POMP 2

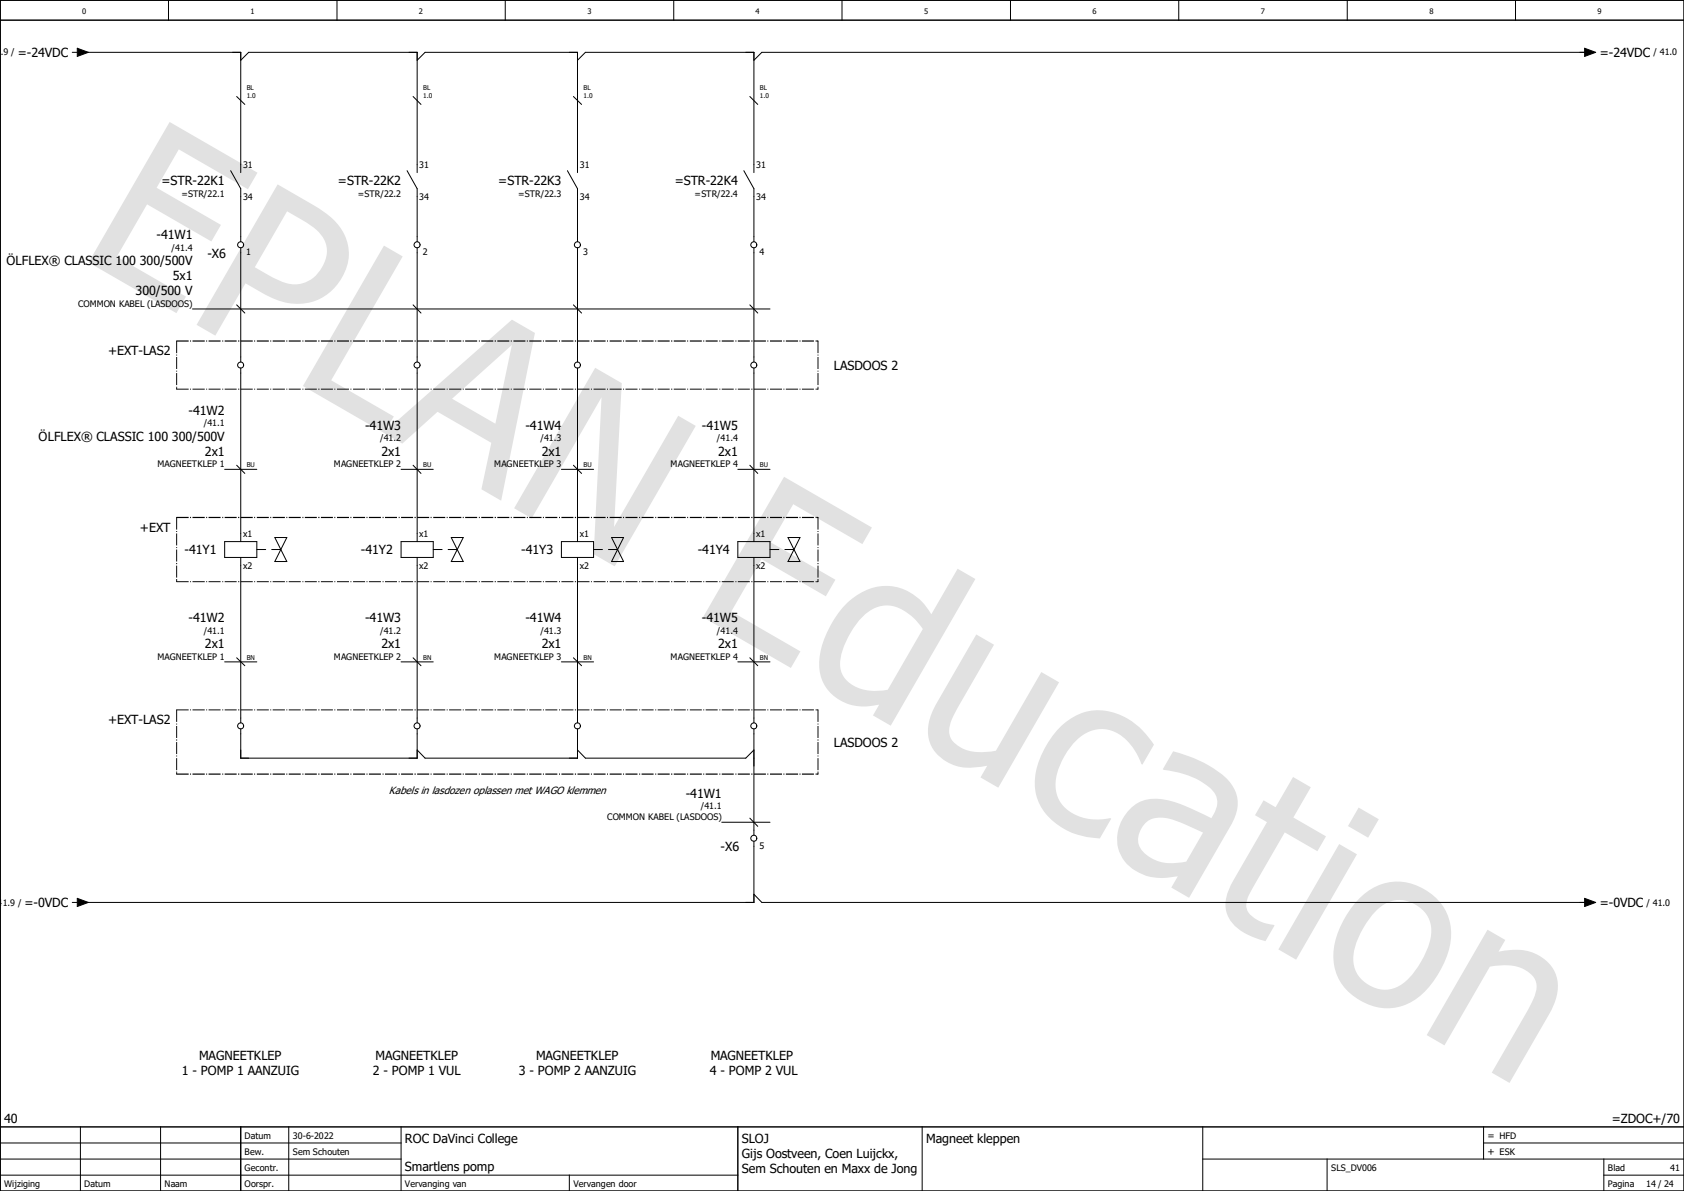
[picture p15: page 14]
HFD; Magneet kleppen; =ZDOC+/70; Sem Schouten en Maxx de Jong; MAGNEETKLEP 1 - POMP 1 AANZUIG; MAGNEETKLEP 2 - POMP 1 VUL; MAGNEETKLEP 3 - POMP 2 AANZUIG; MAGNEETKLEP 4 - POMP 2 VUL; LASDOOS 2; =STR-22K1 =STR/22.1; =STR-22K2 =STR/22.2; =STR-22K3 =STR/22.3; =STR-22K4 =STR/22.4; +EXT-LAS2; ÖLFLEX® CLASSIC 100 300/500V; MAGNEETKLEP 1; MAGNEETKLEP 2; MAGNEETKLEP 3; MAGNEETKLEP 4; +EXT; / =-24VDC; =-24VDC / 41.0; 41.9 / =-0VDC; =-0VDC / 41.0

COMMON KABEL (LASDOOS)

Kabels in lasdozen oplassen met WAGO klemmen

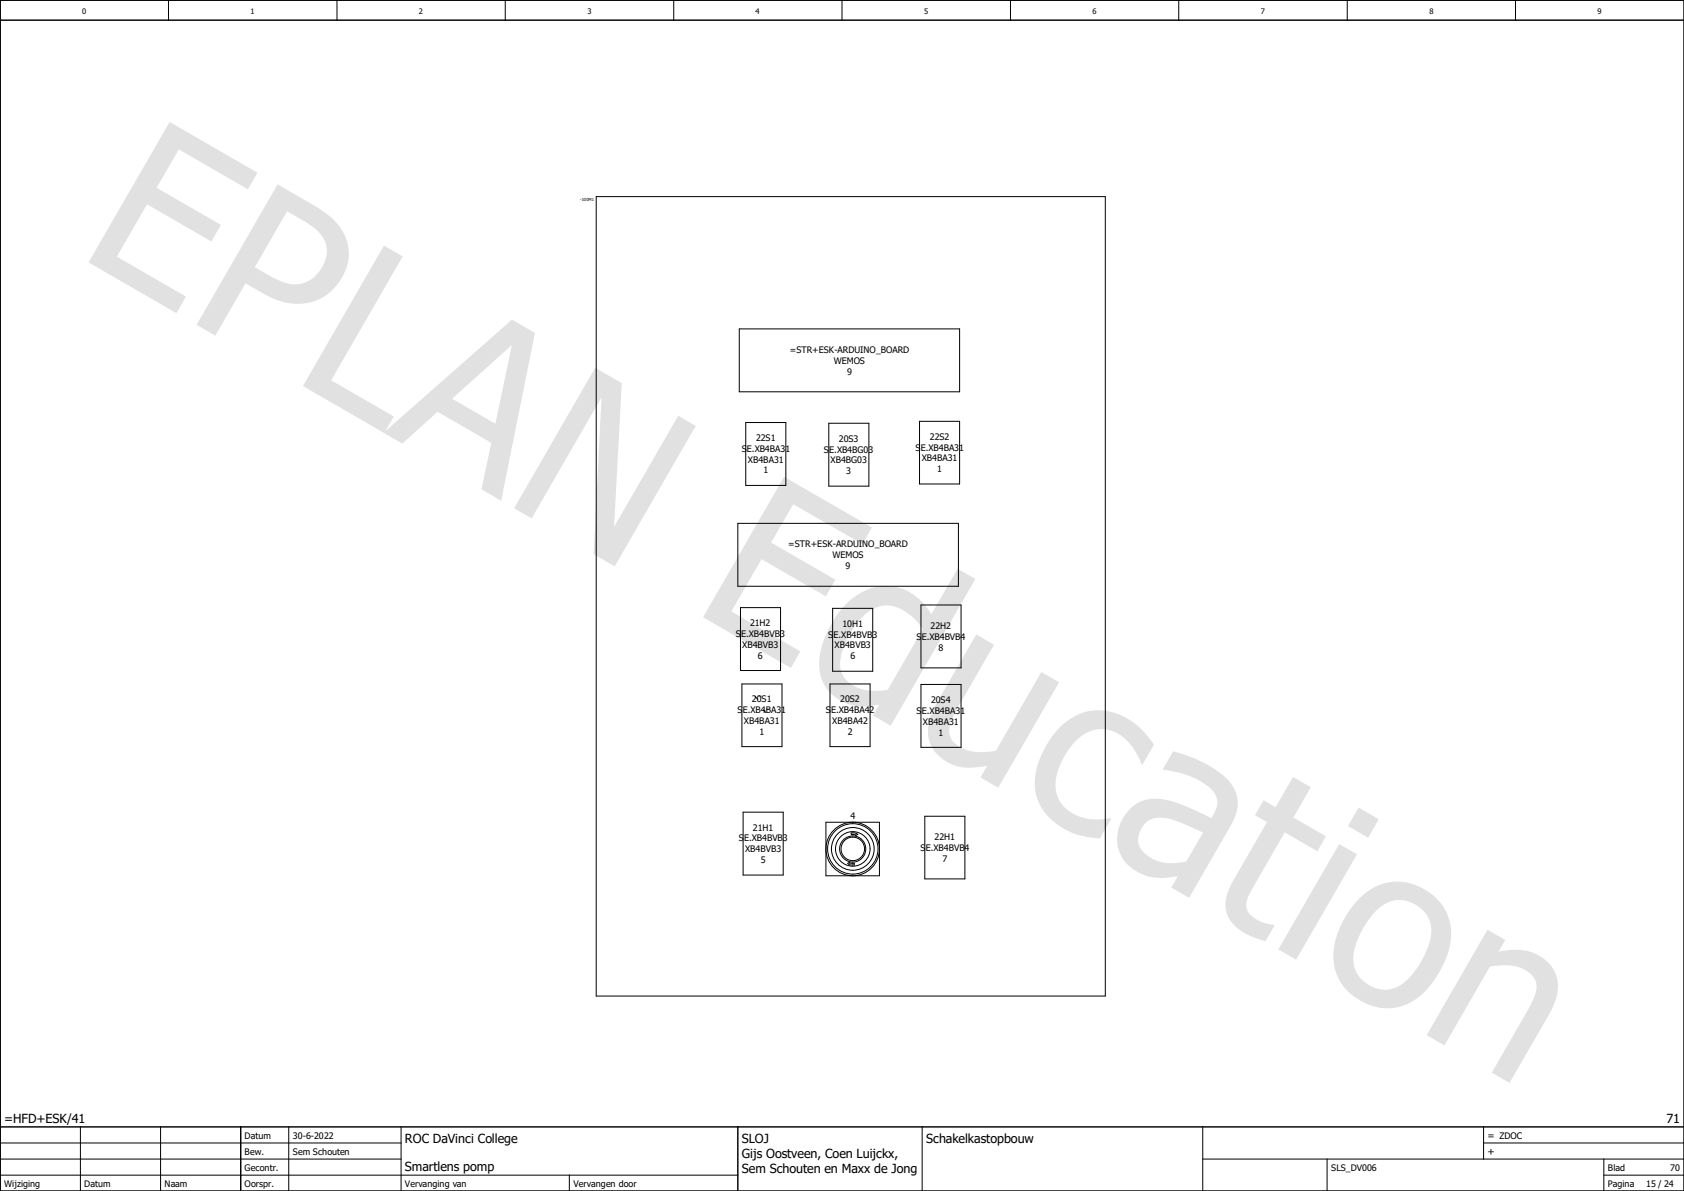
[picture p16: page 15]
=HFD+ESK/41; 21H1 SE.XB4BVB3 XB4BVB3 5; 21H2 SE.XB4BVB3 XB4BVB3 6; 22H1 SE.XB4BVB4 7; 22H2 SE.XB4BVB4 8; =STR+ESK-ARDUINO_BOARD WEMOS 9; 10H1 SE.XB4BVB3 XB4BVB3 6

Sem Schouten en Maxx de Jong | ZDOC Schakelkastopbouw

WIRETRUNK WIRETRUNK | 600 mm

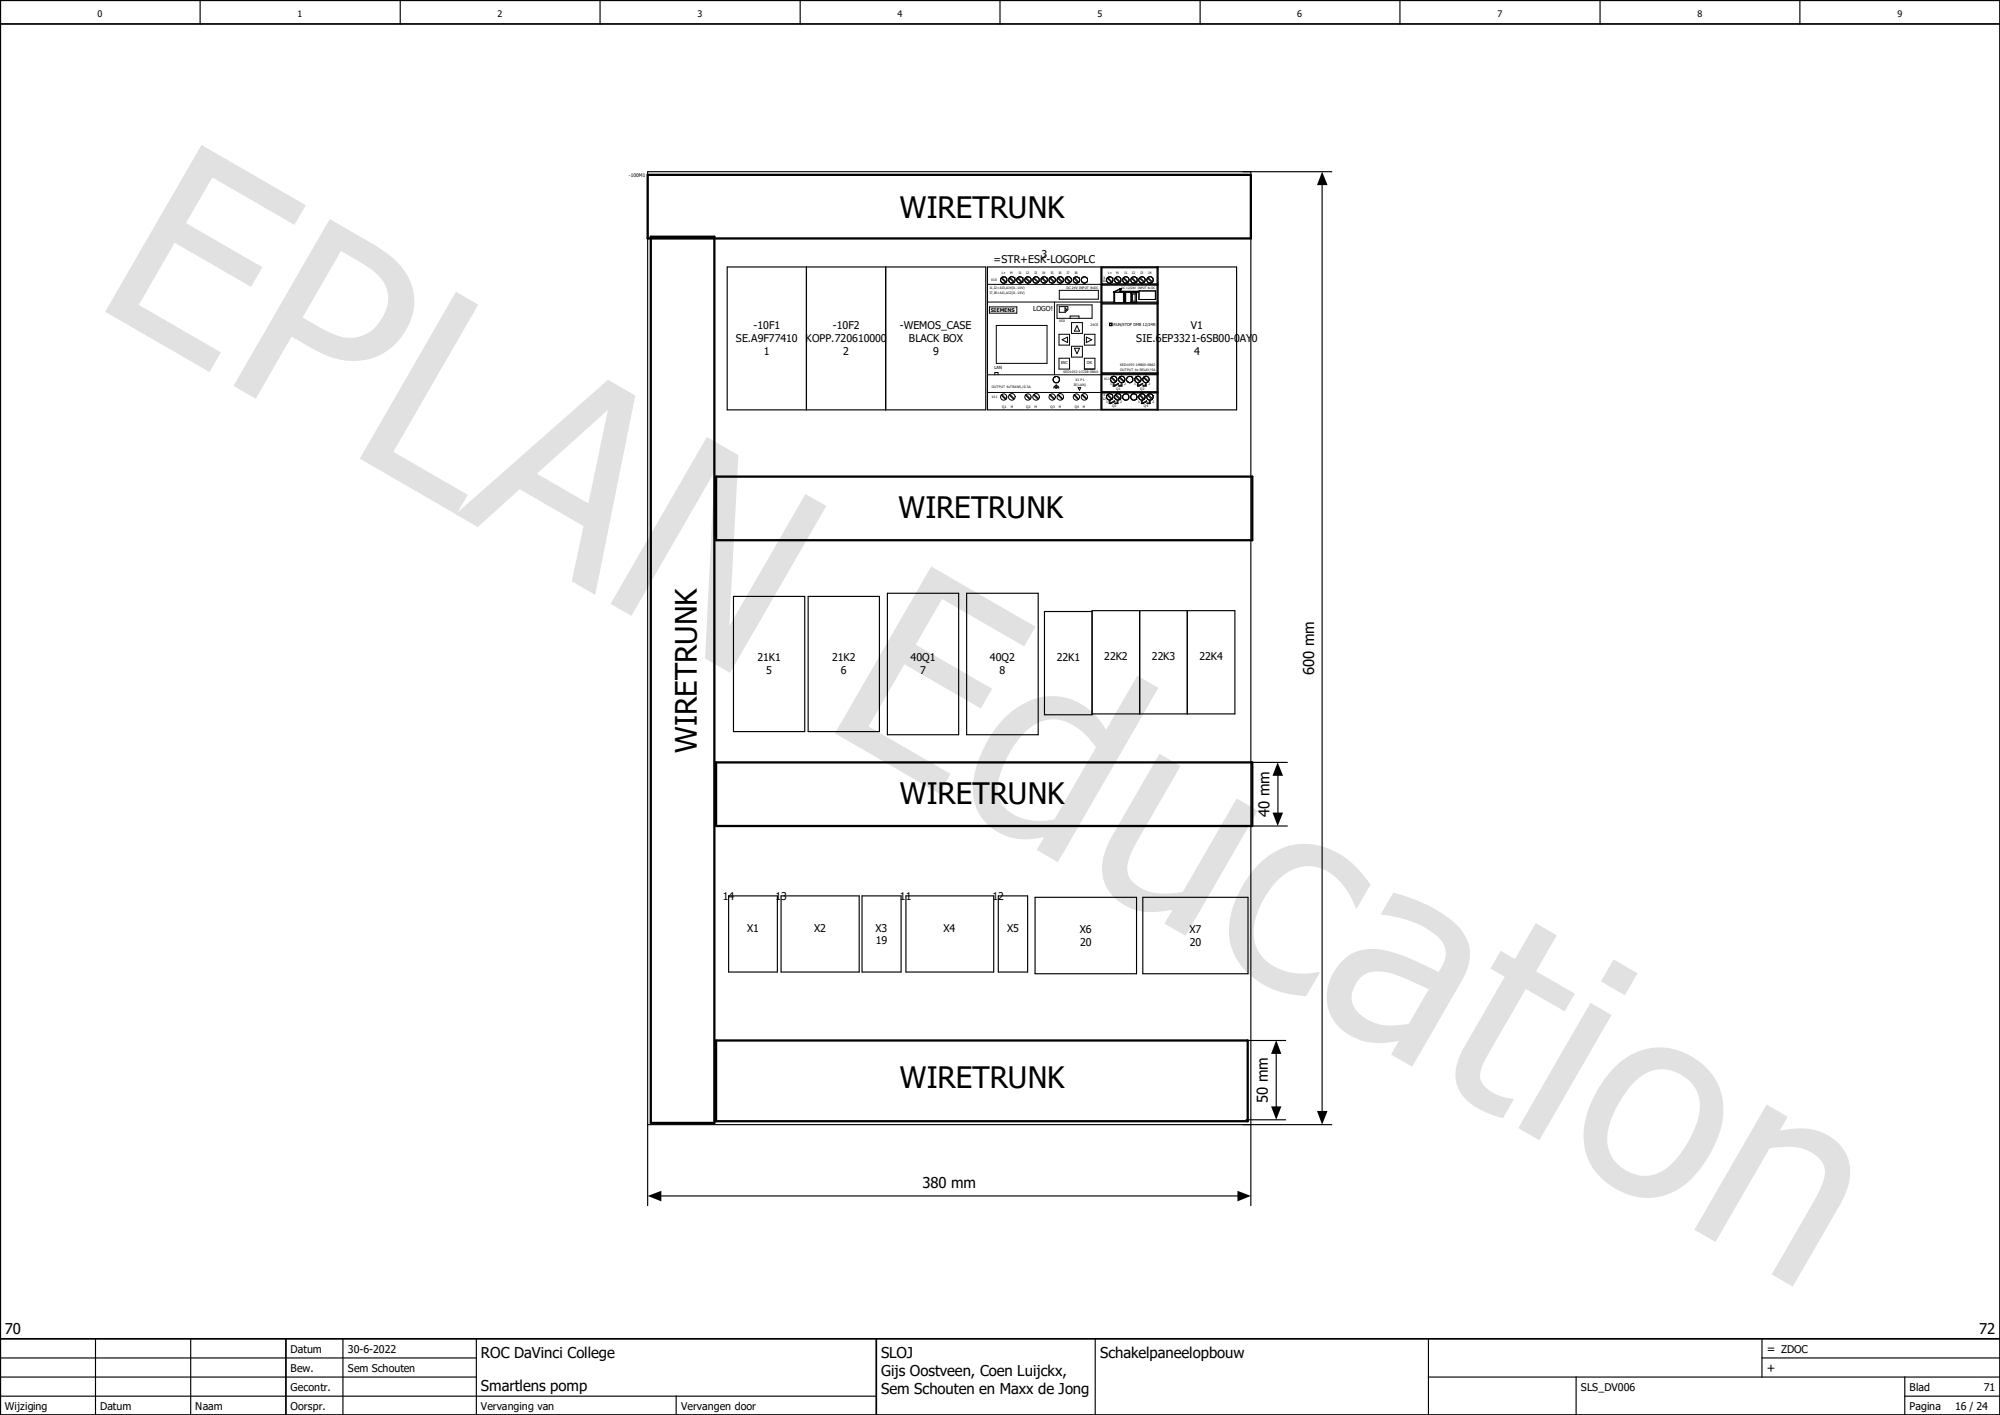
[picture p17: page 16]
LAN; ESC; WIRETRUNK

3 =STR+ESK-LOGOPLC

-10F1 SE.A9F77410 1 | -10F2 KOPP.720610000 2 | -WEMOS_CASE BLACK BOX 9 | L+ M I1 I2 I3 I4 I5 I6 I7 I8 X10 | L+ M I1 I2 I3 I4 10 X SIE.6EP3321-6SB00-0AY0 | V1 4

I1,I2=AI3,AI4(0..10V) DC 24V INPUT 8xDC I7,I8=AI1,AI2(0..10V) | DC 12/24V INPUT 4x DC

SIEMENS LOGO! | RUN/STOP DM8 12/24R 6ED1055-1MB00-0BA2 OUTPUT 4x RELAY/5A

X1 P1 OUTPUT 4xTRANS./0.3A IE(LAN) | X11 1 Q1 2 1 Q2 2

Sem Schouten en Maxx de Jong | ZDOC Schakelpaneelopbouw

# Klemmenstrookoverzicht

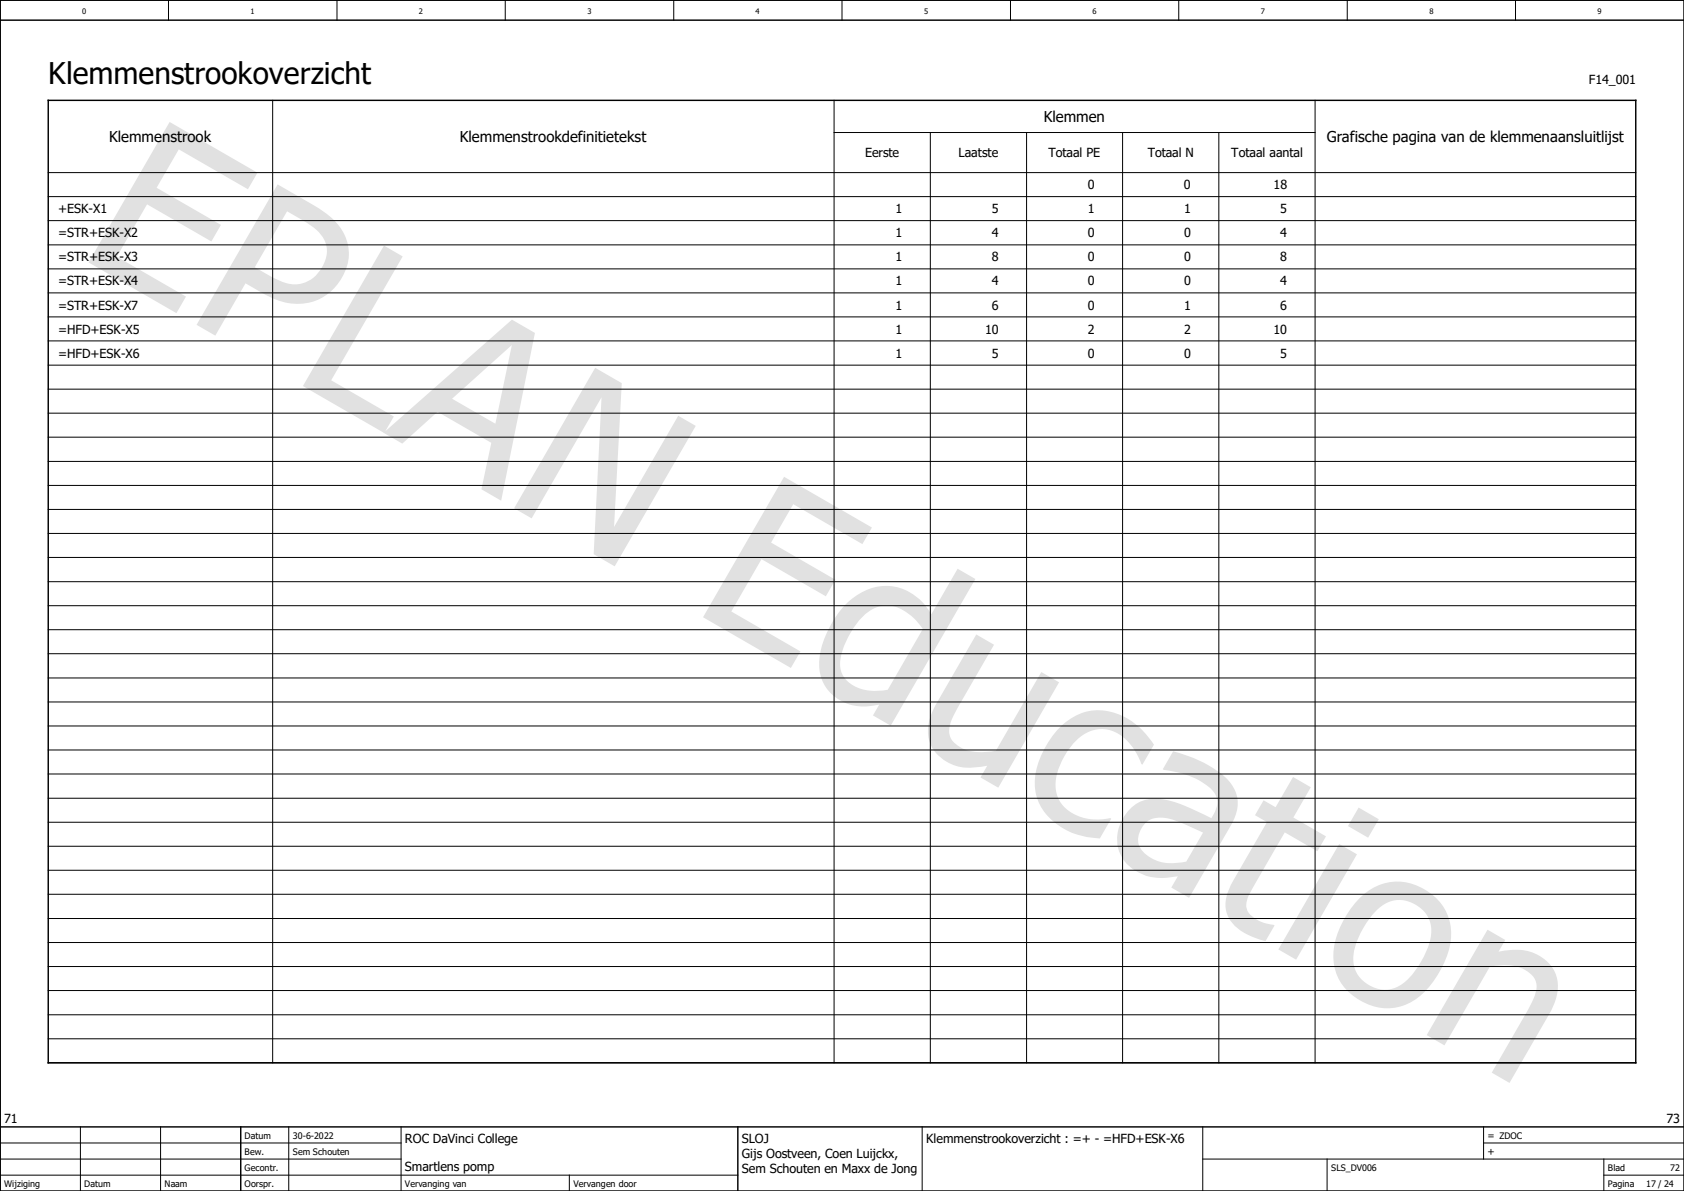
[picture p18: page 17]

Klemmenstrook | Klemmenstrookdefinitietekst | Klemmen | Grafische pagina van de klemmenaansluitlijst

Eerste | Laatste | Totaal PE | Totaal N | Totaal aantal

+ESK-X1 | | 1 | 5 | 1 | 1 | 5
=STR+ESK-X2 | | 1 | 4 | 0 | 0 | 4
=STR+ESK-X3 | | 1 | 8 | 0 | 0 | 8
=STR+ESK-X4 | | 1 | 4 | 0 | 0 | 4
=STR+ESK-X7 | | 1 | 6 | 0 | 1 | 6
=HFD+ESK-X5 | | 1 | 10 | 2 | 2 | 10
=HFD+ESK-X6 | | 1 | 5 | 0 | 0 | 5

Sem Schouten en Maxx de Jong | ZDOC Klemmenstrookoverzicht : =+ - =HFD+ESK-X6

## Projectnaam

## SMART LENSPOMP GR1

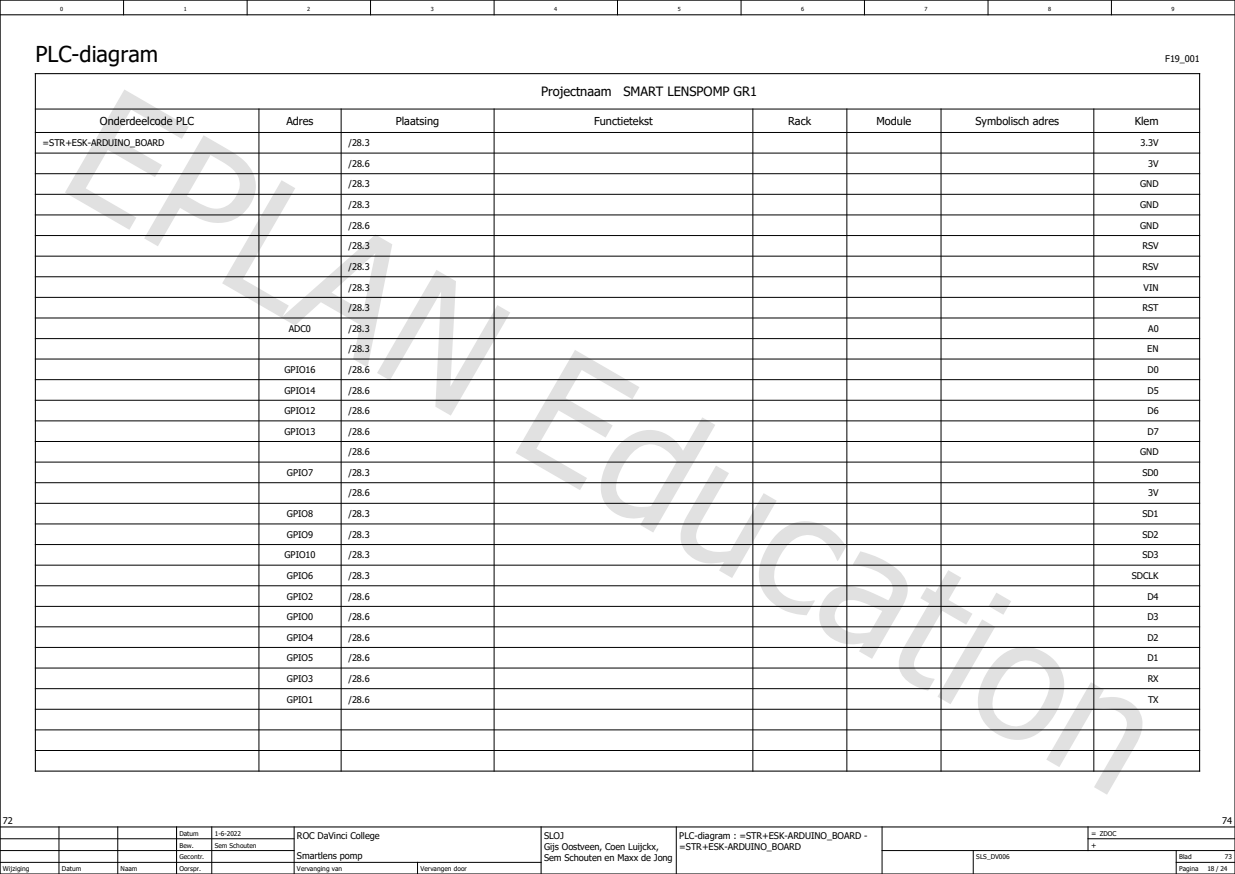
[picture p19: page 18]

Onderdeelcode PLC | Adres | Plaatsing | Functietekst | Rack | Module | Symbolisch adres | Klem

=STR+ESK-ARDUINO_BOARD | | /28.3 | | | | | 3.3V

/28.6 | | | | | 3V
/28.3 | | | | | GND
/28.6 | | | | | GND
/28.3 | | | | | RSV
/28.3 | | | | | VIN
/28.3 | | | | | RST

ADC0 | /28.3 | | | | | A0

GPIO16 | /28.6 | | | | | D0
GPIO14 | /28.6 | | | | | D5
GPIO12 | /28.6 | | | | | D6
GPIO13 | /28.6 | | | | | D7

GPIO7 | /28.3 | | | | | SD0

GPIO8 | /28.3 | | | | | SD1
GPIO9 | /28.3 | | | | | SD2
GPIO10 | /28.3 | | | | | SD3
GPIO6 | /28.3 | | | | | SDCLK
GPIO2 | /28.6 | | | | | D4
GPIO0 | /28.6 | | | | | D3
GPIO4 | /28.6 | | | | | D2
GPIO5 | /28.6 | | | | | D1
GPIO3 | /28.6 | | | | | RX
GPIO1 | /28.6 | | | | | TX

ZDOC PLC-diagram : =STR+ESK-ARDUINO_BOARD -
=STR+ESK-ARDUINO_BOARD

## Projectnaam

## SMART LENSPOMP GR1

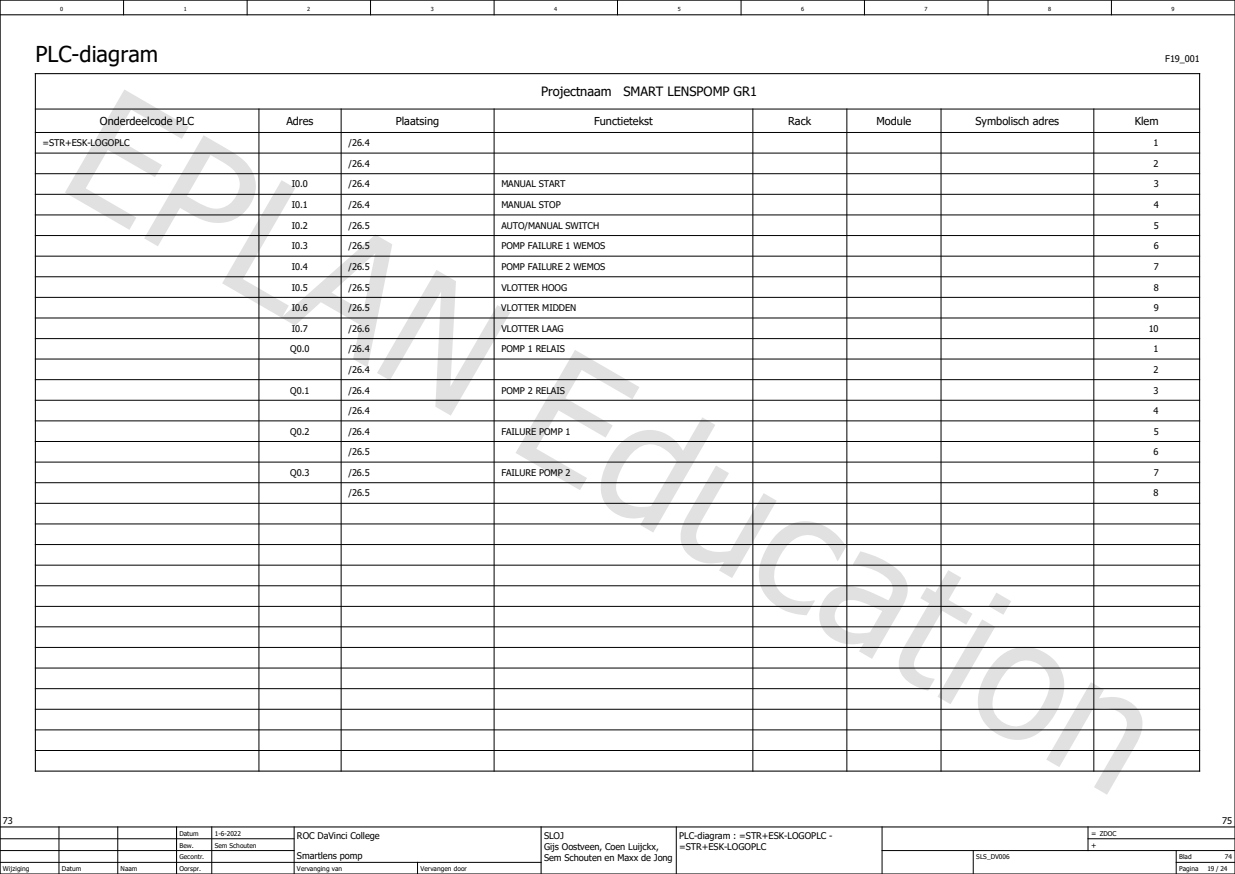
[picture p20: page 19]
SLOJ; Sem Schouten en Maxx de Jong; PLC-diagram

Onderdeelcode PLC | Adres | Plaatsing | Functietekst | Rack | Module | Symbolisch adres | Klem

=STR+ESK-LOGOPLC | | /26.4 | | | | | 1

I0.0 | /26.4 | MANUAL START | | | | 3
I0.1 | /26.4 | MANUAL STOP | | | | 4
I0.2 | /26.5 | AUTO/MANUAL SWITCH | | | | 5
I0.3 | /26.5 | POMP FAILURE 1 WEMOS | | | | 6
I0.4 | /26.5 | POMP FAILURE 2 WEMOS | | | | 7
I0.5 | /26.5 | VLOTTER HOOG | | | | 8
I0.6 | /26.5 | VLOTTER MIDDEN | | | | 9
I0.7 | /26.6 | VLOTTER LAAG | | | | 10
Q0.0 | /26.4 | POMP 1 RELAIS | | | | 1

Q0.1 | /26.4 | POMP 2 RELAIS | | | | 3

Q0.2 | /26.4 | FAILURE POMP 1 | | | | 5

Q0.3 | /26.5 | FAILURE POMP 2 | | | | 7

ZDOC PLC-diagram : =STR+ESK-LOGOPLC -
=STR+ESK-LOGOPLC

## Projectnaam

## SMART LENSPOMP GR1

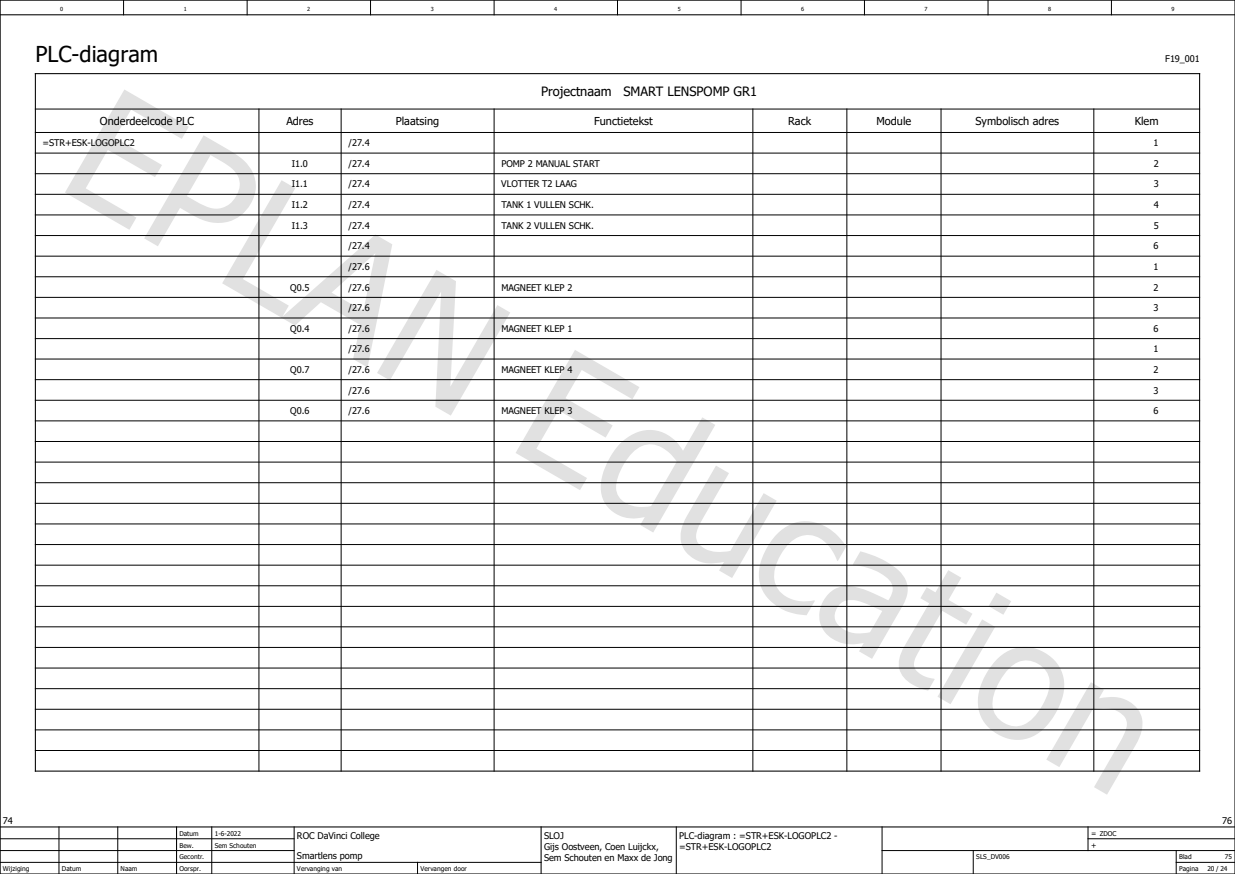
[picture p21: page 20]
SLOJ; Sem Schouten en Maxx de Jong; PLC-diagram

Onderdeelcode PLC | Adres | Plaatsing | Functietekst | Rack | Module | Symbolisch adres | Klem

=STR+ESK-LOGOPLC2 | | /27.4 | | | | | 1

I1.0 | /27.4 | POMP 2 MANUAL START | | | | 2
I1.1 | /27.4 | VLOTTER T2 LAAG | | | | 3
I1.2 | /27.4 | TANK 1 VULLEN SCHK. | | | | 4
I1.3 | /27.4 | TANK 2 VULLEN SCHK. | | | | 5

/27.4 | | | | | 6
/27.6 | | | | | 1

Q0.5 | /27.6 | MAGNEET KLEP 2 | | | | 2

Q0.4 | /27.6 | MAGNEET KLEP 1 | | | | 6

Q0.7 | /27.6 | MAGNEET KLEP 4 | | | | 2

Q0.6 | /27.6 | MAGNEET KLEP 3 | | | | 6

ZDOC PLC-diagram : =STR+ESK-LOGOPLC2 -
=STR+ESK-LOGOPLC2

# Kabeloverzicht

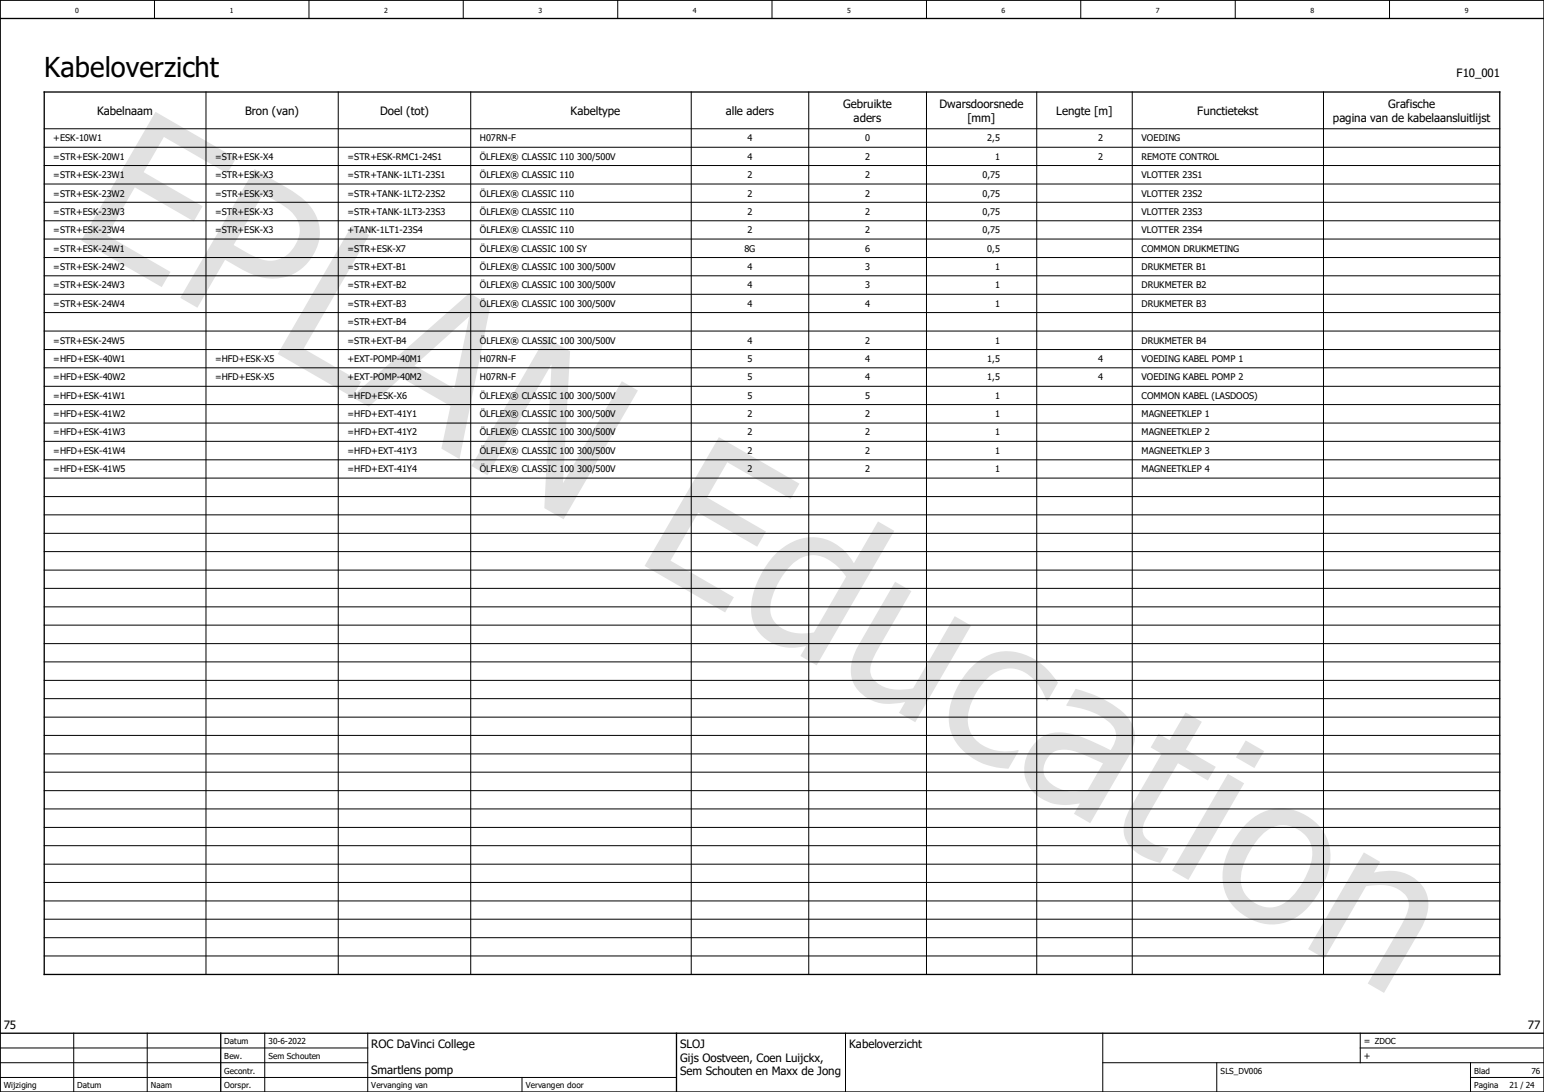
[picture p22: page 21]

Kabeltype | alle aders | Gebruikte aders Doel (tot) | Dwarsdoorsnede [mm] Kabelnaam | Lengte [m] | Functietekst | Grafische pagina van de kabelaansluitlijst Bron (van)

+ESK-10W1 | | | H07RN-F | 4 | 0 | 2,5 | 2 | VOEDING
=STR+ESK-20W1 | =STR+ESK-X4 | =STR+ESK-RMC1-24S1 | ÖLFLEX® CLASSIC 110 300/500V | 4 | 2 | 1 | 2 | REMOTE CONTROL
=STR+ESK-23W1 | =STR+ESK-X3 | | ÖLFLEX® CLASSIC 110 =STR+TANK-1LT1-23S1 | 2 | 2 | 0,75 | | VLOTTER 23S1
=STR+ESK-23W2 | =STR+ESK-X3 | | ÖLFLEX® CLASSIC 110 =STR+TANK-1LT2-23S2 | 2 | 2 | 0,75 | | VLOTTER 23S2
=STR+ESK-23W3 | =STR+ESK-X3 | | ÖLFLEX® CLASSIC 110 =STR+TANK-1LT3-23S3 | 2 | 2 | 0,75 | | VLOTTER 23S3
=STR+ESK-23W4 | =STR+ESK-X3 | | ÖLFLEX® CLASSIC 110 +TANK-1LT1-23S4 | 2 | 2 | 0,75 | | VLOTTER 23S4
=STR+ESK-24W1 | | | ÖLFLEX® CLASSIC 100 SY =STR+ESK-X7 | 8G | 6 | 0,5 | | COMMON DRUKMETING
=STR+ESK-24W2 | | | ÖLFLEX® CLASSIC 100 300/500V =STR+EXT-B1 | 4 | 3 | 1 | | DRUKMETER B1
=STR+ESK-24W3 | | | ÖLFLEX® CLASSIC 100 300/500V =STR+EXT-B2 | 4 | 3 | 1 | | DRUKMETER B2
=STR+ESK-24W4 | | | ÖLFLEX® CLASSIC 100 300/500V =STR+EXT-B3 | 4 | 4 | 1 | | DRUKMETER B3

=STR+EXT-B4

=STR+ESK-24W5 | | | ÖLFLEX® CLASSIC 100 300/500V =STR+EXT-B4 | 4 | 2 | 1 | | DRUKMETER B4
=HFD+ESK-40W1 | =HFD+ESK-X5 | | H07RN-F +EXT-POMP-40M1 | 5 | 4 | 1,5 | 4 | VOEDING KABEL POMP 1
=HFD+ESK-40W2 | =HFD+ESK-X5 | | H07RN-F +EXT-POMP-40M2 | 5 | 4 | 1,5 | 4 | VOEDING KABEL POMP 2
=HFD+ESK-41W1 | | =HFD+ESK-X6 | ÖLFLEX® CLASSIC 100 300/500V | 5 | 5 | 1 | | COMMON KABEL (LASDOOS)
=HFD+ESK-41W2 | | | ÖLFLEX® CLASSIC 100 300/500V =HFD+EXT-41Y1 | 2 | 2 | 1 | | MAGNEETKLEP 1
=HFD+ESK-41W3 | | | ÖLFLEX® CLASSIC 100 300/500V =HFD+EXT-41Y2 | 2 | 2 | 1 | | MAGNEETKLEP 2
=HFD+ESK-41W4 | | | ÖLFLEX® CLASSIC 100 300/500V =HFD+EXT-41Y3 | 2 | 2 | 1 | | MAGNEETKLEP 3
=HFD+ESK-41W5 | | | ÖLFLEX® CLASSIC 100 300/500V =HFD+EXT-41Y4 | 2 | 2 | 1 | | MAGNEETKLEP 4

Sem Schouten en Maxx de Jong | ZDOC Kabeloverzicht

Artikellijstoverzicht | F02_001

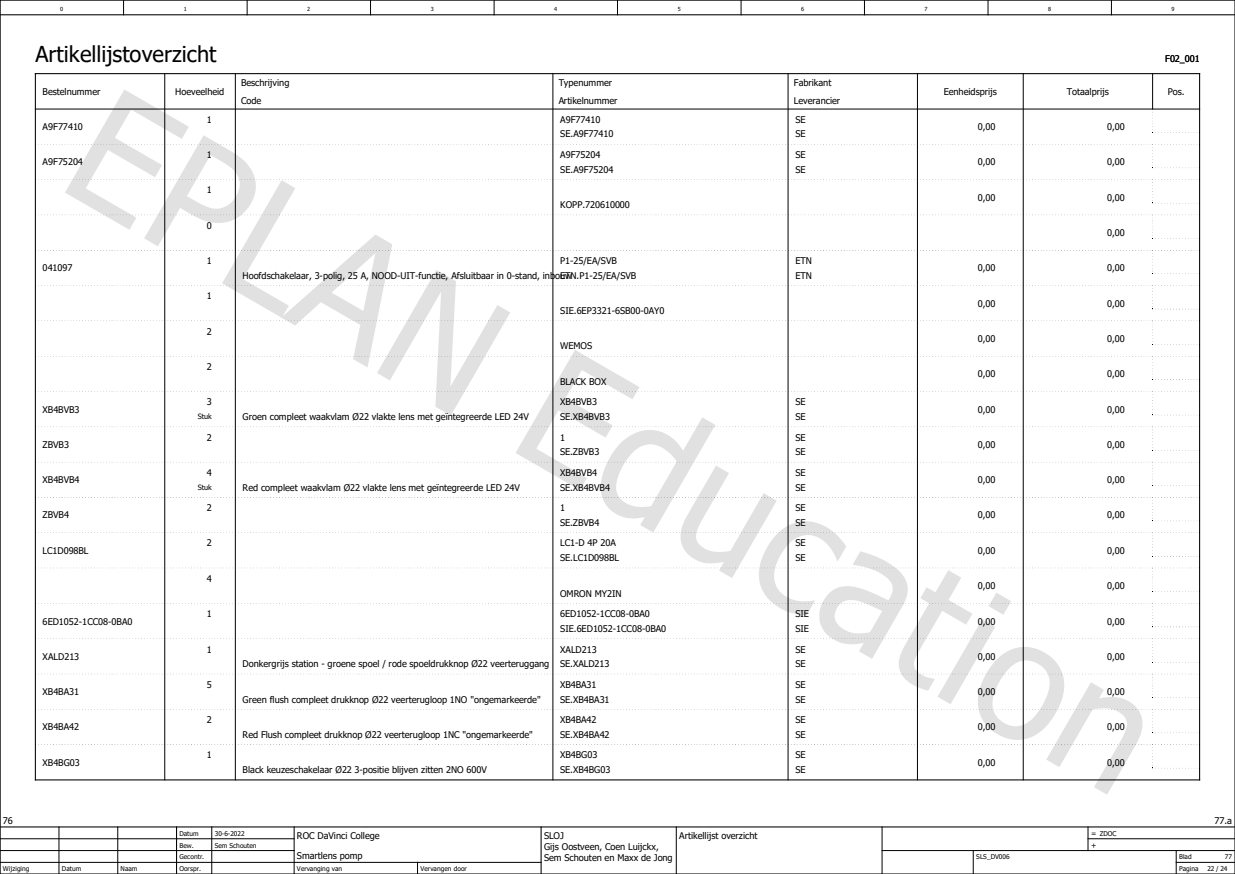
[picture p23: page 22]
Bestelnummer; Pos.; Typenummer; Fabrikant; Code; Artikelnummer; Leverancier; Hoeveelheid; Beschrijving; Eenheidsprijs; Totaalprijs; KOPP.720610000; SIE.6EP3321-6SB00-0AY0; WEMOS; BLACK BOX; SE.XB4BVB3; SE.ZBVB3; SE.XB4BVB4; 4 XB4BVB4; Red compleet waakvlam Ø22 vlakte lens met geïntegreerde LED 24V; XB4BVB4; SE.ZBVB4; ZBVB4; OMRON MY2IN; SIE.6ED1052-1CC08-0BA0; SIE; SE.XALD213; Hoofdschakelaar, 3-polig, 25 A, NOOD-UIT-functie, Afsluitbaar in 0-stand, inbouw; ETN; XALD213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

P1-25/EA/SVB
ETN.P1-25/EA/SVB

Sem Schouten en Maxx de Jong | ZDOC Artikellijst overzicht

Artikellijstoverzicht | F02_001

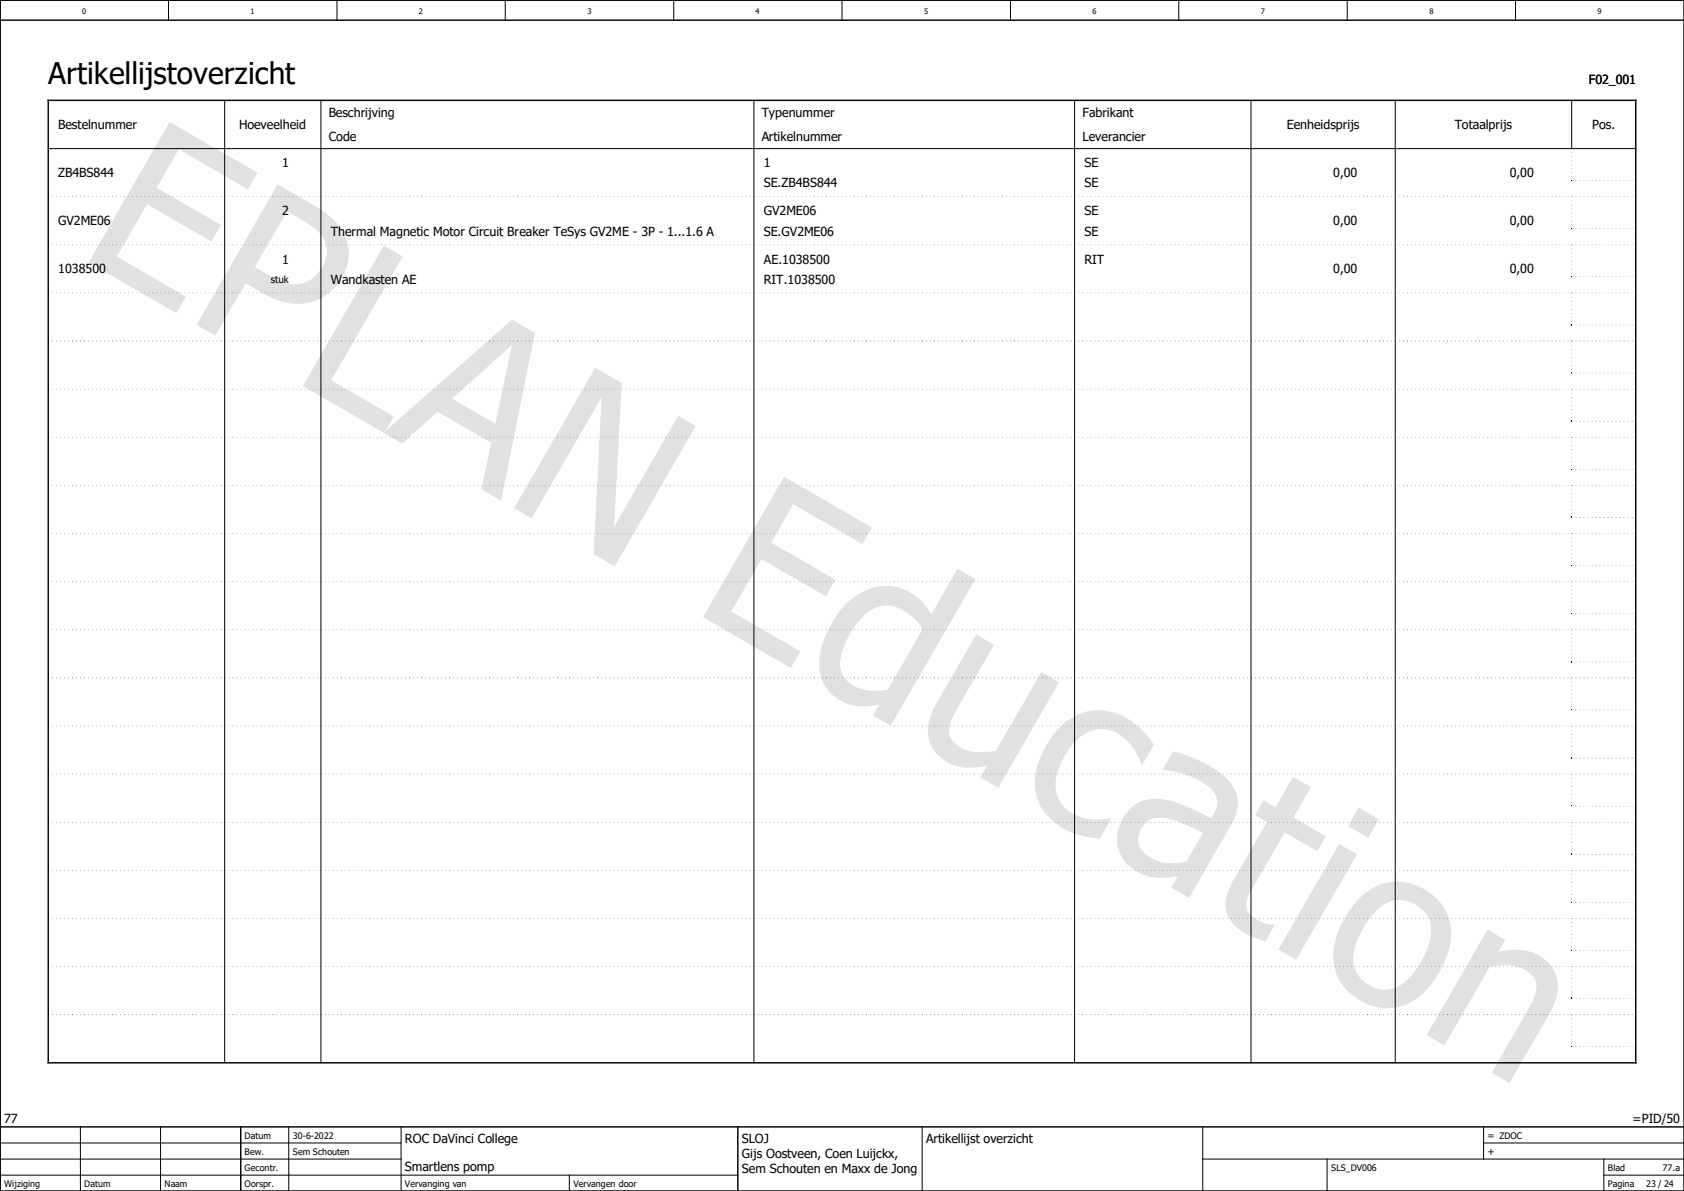
[picture p24: page 23]
=PID/50; Bestelnummer; Pos.; Typenummer; Fabrikant; Code; Artikelnummer; Leverancier; Hoeveelheid; Beschrijving; Eenheidsprijs; Totaalprijs; RIT.1038500; 1 AE.1038500 Wandkasten AE; RIT 1038500 0,00; Thermal Magnetic Motor Circuit Breaker TeSys GV2ME - 3P - 1...1.6 A; stuk

Sem Schouten en Maxx de Jong | ZDOC Artikellijst overzicht

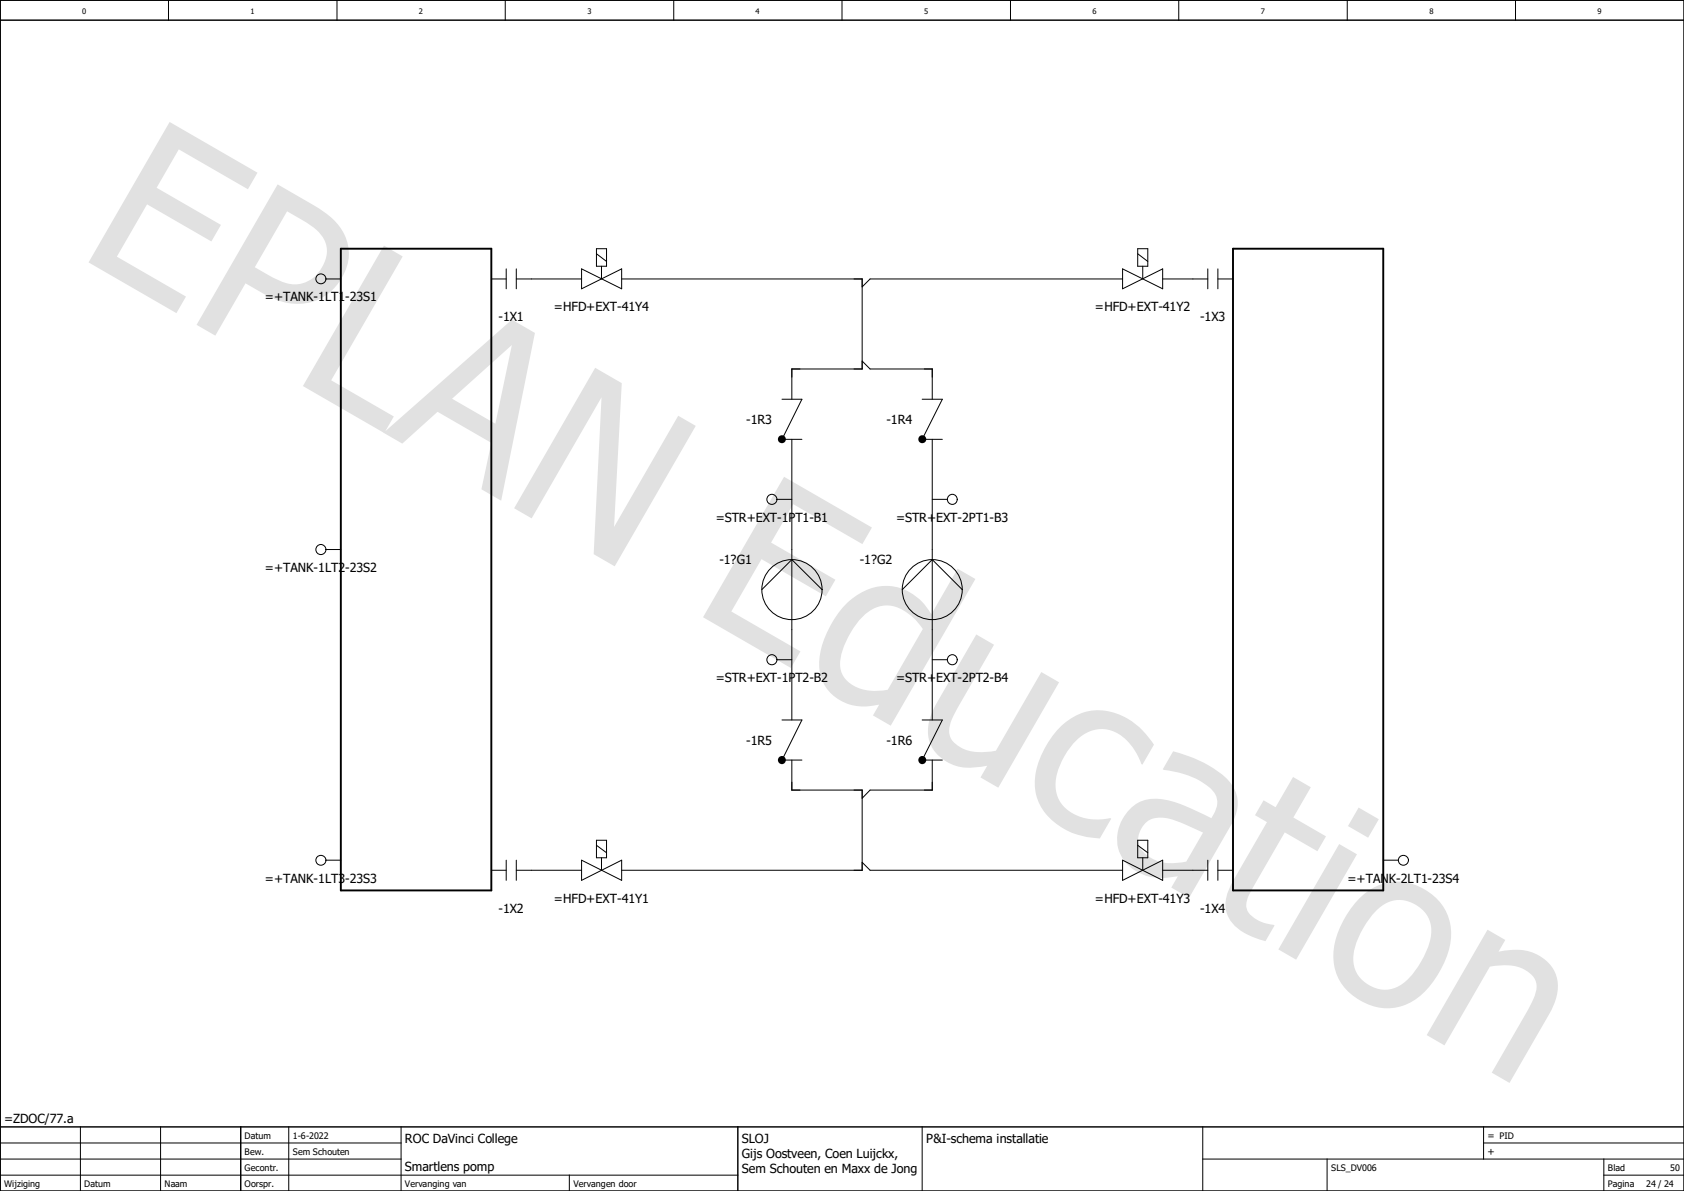
[picture p25: page 24]
=ZDOC/77.a; SLOJ; Sem Schouten en Maxx de Jong; =HFD+EXT-41Y1; =HFD+EXT-41Y4; =HFD+EXT-41Y2; =HFD+EXT-41Y3; =STR+EXT-1PT1-B1; =STR+EXT-1PT2-B2; =STR+EXT-2PT1-B3; =STR+EXT-2PT2-B4; =+TANK-1LT1-23S1; =+TANK-1LT2-23S2; =+TANK-1LT3-23S3; =+TANK-2LT1-23S4

PID P&I-schema installatie
