MKEadmin/Waterpomp/(list of files, drawings)

Other design files:
Documentatie/pomp.fzz
